shjoo0407/SentiFrame/HW/SentiFrame.csv

Reference | Qty | Value | DNP | Exclude from BOM | Exclude from Board | Exclude from Simulation | Exclude from Position Files | Footprint | Datasheet
BT1 | 1 | 1S protected LiPo >=100mAh |  |  | 기판에서 제외됨 |  | ${EXCLUDE_FROM_POS_FILES}
C1,C10,C12,C15,C17,C23,C25,C26 | 8 | 4.7uF 25V X5R |  |  |  |  | ${EXCLUDE_FROM_POS_FILES} | SentiFrame:C_0603_1608Metric | https://product.tdk.com/en/search/capacitor/ceramic/mlcc/info?part_no=C1608X5R1E475K080AC
C2,C5,C6,C11,C13,C14,C20,C22,C31,C34,C35 | 11 | 100nF 16V X7R |  |  |  |  | ${EXCLUDE_FROM_POS_FILES} | SentiFrame:C_0402_1005Metric | https://product.tdk.com/en/search/capacitor/ceramic/mlcc/info?part_no=C1005X7R1C104K050BC
C7,C8 | 2 | 1uF 25V X5R |  |  | 기판에서 제외됨 |  | ${EXCLUDE_FROM_POS_FILES} | SentiFrame:C_0402_1005Metric | https://product.tdk.com/en/search/capacitor/ceramic/mlcc/info?part_no=C1005X5R1E105K050BC
C9 | 1 | 10uF 25V X5R |  |  | 기판에서 제외됨 |  | ${EXCLUDE_FROM_POS_FILES} | SentiFrame:C_0805_2012Metric | https://product.tdk.com/en/search/capacitor/ceramic/mlcc/info?part_no=C2012X5R1E106K125AB
C16,C19,C27,C28,C29,C30 | 6 | 22uF 25V X5R |  |  |  |  | ${EXCLUDE_FROM_POS_FILES} | SentiFrame:C_0805_2012Metric | https://product.tdk.com/en/search/capacitor/ceramic/mlcc/info?part_no=C2012X5R1E226M125AC
C18,C21 | 2 | 10uF 25V X5R |  |  |  |  | ${EXCLUDE_FROM_POS_FILES} | SentiFrame:C_0805_2012Metric | https://product.tdk.com/en/search/capacitor/ceramic/mlcc/info?part_no=C2012X5R1E106K125AB
C24 | 1 | 4.7nF 50V X7R |  |  |  |  | ${EXCLUDE_FROM_POS_FILES} | SentiFrame:C_0402_1005Metric | https://product.tdk.com/en/search/capacitor/ceramic/mlcc/info?part_no=C1005X7R1H472K050BA
C32 | 1 | 10nF 50V X7R |  |  |  |  | ${EXCLUDE_FROM_POS_FILES} | SentiFrame:C_0402_1005Metric | https://product.tdk.com/en/search/capacitor/ceramic/mlcc/info?part_no=C1005X7R1H103K050BB
C33 | 1 | 1uF 25V X5R |  |  |  |  | ${EXCLUDE_FROM_POS_FILES} | SentiFrame:C_0603_1608Metric | https://product.tdk.com/en/search/capacitor/ceramic/mlcc/info?part_no=C1608X5R1E105K080AC
D1,D2,D3 | 3 | TPD1E10B06DPYR |  |  |  |  | ${EXCLUDE_FROM_POS_FILES} | SentiFrame:D_SOD-523 | https://www.ti.com/lit/ds/symlink/tpd1e10b06.pdf
D4 | 1 | BAT54H,115 |  |  |  |  | ${EXCLUDE_FROM_POS_FILES} | SentiFrame:D_SOD-123F | https://assets.nexperia.com/documents/data-sheet/BAT54H.pdf
D5 | 1 | APHHS1005SURCK |  |  |  |  | ${EXCLUDE_FROM_POS_FILES} | SentiFrame:LED_0402_1005Metric | https://www.kingbrightusa.com/images/catalog/spec/aphhs1005surck.pdf
J1 | 1 | USB4105-GF-A |  |  |  |  | ${EXCLUDE_FROM_POS_FILES} | SentiFrame:USB_C_Receptacle_GCT_USB4105-xx-A_16P_TopMnt_Horizontal | https://gct.co/files/drawings/usb4105.pdf
J2 | 1 | JST SH / PACK + GND NTC |  |  |  |  | ${EXCLUDE_FROM_POS_FILES} | SentiFrame:JST_SH_SM03B-SRSS-TB_1x03-1MP_P1.00mm_Horizontal
J4 | 1 | SM05B-SURS-TF / PPG MAIN |  |  |  |  | ${EXCLUDE_FROM_POS_FILES} | SentiFrame:JST_SUR_SM05B-SURS-TF_J4_SilkClearance | https://www.jst-mfg.com/product/pdf/eng/eSUR.pdf
J5 | 1 | SM05B-SURS-TF / PPG REMOTE |  |  | 기판에서 제외됨 |  | ${EXCLUDE_FROM_POS_FILES} | SentiFrame:JST_SUR_SM05B-SURS-TF_1x05-1MP_P0.80mm_Horizontal | https://www.jst-mfg.com/product/pdf/eng/eSUR.pdf
L1 | 1 | 4.7uH / 0.30A Isat typ |  |  |  |  | ${EXCLUDE_FROM_POS_FILES} | SentiFrame:L_HPC160809TF_DS | https://www.tai-tech.com.tw/pdf/284799/HPC160809TF-SERIES.pdf
L2,L3 | 2 | 2.2uH DFE201612E |  |  |  |  | ${EXCLUDE_FROM_POS_FILES} | SentiFrame:L_DFE201612E_DS | https://www.ti.com/lit/ds/symlink/tps62840.pdf,https://www.ti.com/lit/ds/symlink/tps63900.pdf
M1 | 1 | PMD 303-103 / external |  |  | 기판에서 제외됨 |  | ${EXCLUDE_FROM_POS_FILES} |  | https://precisionmicrodrives.com/cdn/catalog_product/a43fe981-4a1e-4aa2-bfc0-005ce2c3eb36/303-103-datasheet.pdf
Q1,Q2,Q3,Q4,Q5 | 5 | DMN1019USN-7 |  |  |  |  | ${EXCLUDE_FROM_POS_FILES} | SentiFrame:SC-59 | https://www.diodes.com/assets/Datasheets/DMN1019USN.pdf
R1,R8,R13,R16,R17,R36,R37,R38 | 8 | 10k 1% |  |  |  |  | ${EXCLUDE_FROM_POS_FILES} | SentiFrame:R_0402_1005Metric | https://yageogroup.com/content/datasheet/asset/file/PYU-RC_GROUP_51_ROHS_L
R2,R3,R20 | 3 | 2.2k 1% |  |  |  |  | ${EXCLUDE_FROM_POS_FILES} | SentiFrame:R_0402_1005Metric | https://yageogroup.com/content/datasheet/asset/file/PYU-RC_GROUP_51_ROHS_L
R4,R5,R12,R14,R15,R19,R21,R25,R26,R27,R28,R30,R31,R39 | 14 | 100k 1% |  |  |  |  | ${EXCLUDE_FROM_POS_FILES} | SentiFrame:R_0402_1005Metric | https://yageogroup.com/content/datasheet/asset/file/PYU-RC_GROUP_51_ROHS_L
R9 | 1 | 22.1k 1% |  |  |  |  | ${EXCLUDE_FROM_POS_FILES} | SentiFrame:R_0402_1005Metric | https://yageogroup.com/content/datasheet/asset/file/PYU-RC_GROUP_51_ROHS_L
R10 | 1 | 47.5k 1% |  |  |  |  | ${EXCLUDE_FROM_POS_FILES} | SentiFrame:R_0402_1005Metric | https://yageogroup.com/content/datasheet/asset/file/PYU-RC_GROUP_51_ROHS_L
R11 | 1 | 1k 1% |  |  |  |  | ${EXCLUDE_FROM_POS_FILES} | SentiFrame:R_0402_1005Metric | https://yageogroup.com/content/datasheet/asset/file/PYU-RC_GROUP_51_ROHS_L
R18 | 1 | 100 1% |  |  |  |  | ${EXCLUDE_FROM_POS_FILES} | SentiFrame:R_0402_1005Metric | https://yageogroup.com/content/datasheet/asset/file/PYU-RC_GROUP_51_ROHS_L
R22,R24 | 2 | 36.5k 1% |  |  |  |  | ${EXCLUDE_FROM_POS_FILES} | SentiFrame:R_0402_1005Metric | https://yageogroup.com/content/datasheet/asset/file/PYU-RC_GROUP_51_ROHS_L
R23 | 1 | 8.25k 1% |  |  |  |  | ${EXCLUDE_FROM_POS_FILES} | SentiFrame:R_0402_1005Metric | https://yageogroup.com/content/datasheet/asset/file/PYU-RC_GROUP_51_ROHS_L
R29 | 1 | 47k 1% |  |  |  |  | ${EXCLUDE_FROM_POS_FILES} | SentiFrame:R_0402_1005Metric | https://yageogroup.com/content/datasheet/asset/file/PYU-RC_GROUP_51_ROHS_L
R32 | 1 | 1.74k 1% |  |  |  |  | ${EXCLUDE_FROM_POS_FILES} | SentiFrame:R_0402_1005Metric | https://yageogroup.com/content/datasheet/asset/file/PYU-RC_GROUP_51_ROHS_L
R33,R34,R35 | 3 | 2.2 1% |  |  |  |  | ${EXCLUDE_FROM_POS_FILES} | SentiFrame:R_0402_1005Metric | https://yageogroup.com/content/datasheet/asset/file/PYU-RC_GROUP_51_ROHS_L
R40 | 1 | 887k 1% |  |  |  |  | ${EXCLUDE_FROM_POS_FILES} | SentiFrame:R_0402_1005Metric | https://yageogroup.com/content/datasheet/asset/file/PYU-RC_GROUP_51_ROHS_L
SW1 | 1 | B3U-1000P / SOS |  |  |  |  | ${EXCLUDE_FROM_POS_FILES} | SentiFrame:SW_SPST_B3U-1000P | https://components.omron.com/us-en/system/files/2023-01/datasheet_pdf/A162-E1.pdf
SW2 | 1 | B3U-1000P / POWER |  |  |  |  | ${EXCLUDE_FROM_POS_FILES} | SentiFrame:SW_SPST_B3U-1000P | https://components.omron.com/us-en/system/files/2023-01/datasheet_pdf/A162-E1.pdf
TH1 | 1 | SEMITEC 103AT-2 / external |  |  | 기판에서 제외됨 |  | ${EXCLUDE_FROM_POS_FILES} |  | https://www.semitec-global.com/uploads/2022/01/P12-13-AT-Thermistor.pdf
U1 | 1 | AN54LV-15 |  |  |  |  | ${EXCLUDE_FROM_POS_FILES} | SentiFrame:AN54LV-15 | https://www.raytac.com/document/act.php?act=1&index_id=101
U2 | 1 | BMI270 / I2C 0x68 |  |  |  |  | ${EXCLUDE_FROM_POS_FILES} | SentiFrame:BMI270_LGA14_DS00008 | https://www.bosch-sensortec.com/media/boschsensortec/downloads/datasheets/bst-bmi270-ds000.pdf
U3 | 1 | MAXM86161AEFD+T / 0x62 |  |  | 기판에서 제외됨 |  | ${EXCLUDE_FROM_POS_FILES} | SentiFrame:MAXM86161A_OLGA14_2.9x4.3mm | https://www.analog.com/media/en/technical-documentation/data-sheets/maxm86161a.pdf
U4 | 1 | CP2102N-A02-GQFN20 |  |  |  |  | ${EXCLUDE_FROM_POS_FILES} | SentiFrame:SiliconLabs_QFN-20-1EP_3x3mm_P0.5mm_EP1.8x1.8mm | https://www.silabs.com/documents/public/data-sheets/cp2102n-datasheet.pdf
U5 | 1 | TXU0202DCUR |  |  |  |  | ${EXCLUDE_FROM_POS_FILES} | SentiFrame:VSSOP-8_2.3x2mm_P0.5mm | https://www.ti.com/lit/ds/symlink/txu0202.pdf
U6 | 1 | TPD2EUSB30DRTR |  |  |  |  | ${EXCLUDE_FROM_POS_FILES} | SentiFrame:Texas_DRT-3 | https://www.ti.com/lit/ds/symlink/tpd2eusb30.pdf
U7 | 1 | BQ25186DLHR / 0x6A |  |  |  |  | ${EXCLUDE_FROM_POS_FILES} | SentiFrame:Texas_DLH0010A_WSON-10-1EP_2.2x2mm_P0.4mm_EP0.9x1.5mm | https://www.ti.com/lit/ds/symlink/bq25186.pdf
U8 | 1 | TPS62840DLCR / 2.0V |  |  |  |  | ${EXCLUDE_FROM_POS_FILES} | SentiFrame:Texas_VSON-HR-8_1.5x2mm_P0.5mm | https://www.ti.com/lit/ds/symlink/tps62840.pdf
U9 | 1 | TPS63900DSKR / PPG 5V |  |  |  |  | ${EXCLUDE_FROM_POS_FILES} | SentiFrame:WSON-10-1EP_2.5x2.5mm_P0.5mm_EP1.2x2mm | https://www.ti.com/lit/ds/symlink/tps63900.pdf
U10 | 1 | TPS7A0230PDBVR / 3V |  |  |  |  | ${EXCLUDE_FROM_POS_FILES} | SentiFrame:SOT-23-5 | https://www.ti.com/lit/ds/symlink/tps7a02.pdf
U11 | 1 | TPS22918DBVR |  |  |  |  | ${EXCLUDE_FROM_POS_FILES} | SentiFrame:SOT-23-6 | https://www.ti.com/lit/ds/symlink/tps22918.pdf
U12 | 1 | TPS22918DBVR / ADC gate |  |  |  |  | ${EXCLUDE_FROM_POS_FILES} | SentiFrame:SOT-23-6 | https://www.ti.com/lit/ds/symlink/tps22918.pdf
U13 | 1 | BQ24392RSER |  |  |  |  | ${EXCLUDE_FROM_POS_FILES} | SentiFrame:Texas_UQFN-10_1.5x2mm_P0.5mm | https://www.ti.com/lit/ds/symlink/bq24392.pdf
U14 | 1 | TUSB320LAIRWBR / 0x47 |  |  |  |  | ${EXCLUDE_FROM_POS_FILES} | SentiFrame:Texas_X2QFN-12_1.6x1.6mm_P0.4mm | https://www.ti.com/lit/ds/symlink/tusb320lai.pdf
