shjoo0407/SentiFrame/HW/SentiFrame-PPG.kicad_pcb

## KiCad design HW/SentiFrame-PPG.kicad_pcb (2026-11-08)

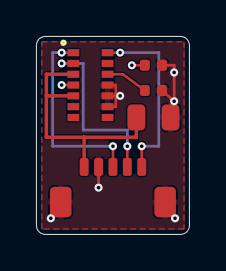
[picture p1: board SentiFrame-PPG.kicad_pcb from above]

Board: 4 copper layers, 8.5 x 11.0 mm, 5 parts (0 on the bottom side), 7 nets.

Parts:
C7, C8: 1uF 25V X5R; C_0402_1005Metric
C9: 10uF 25V X5R; C_0805_2012Metric
J5: SM05B-SURS-TF / PPG REMOTE; JST_SUR_SM05B-SURS-TF_1x05-1MP_P0.80mm_Horizontal
U3: MAXM86161AEFD+T / 0x62; MAXM86161A_OLGA14_2.9x4.3mm

Connections:
GND: C7.2, C8.2, C9.2, J5.2, J5.MP, U3.9, U3.10, U3.11
I2C_SCL: J5.4, U3.2
I2C_SDA: J5.3, U3.1
PPG5V: C9.1, J5.1, U3.3, U3.5
PPG_INT_N: J5.5, U3.14
PPG_VLDO: C7.1, U3.4
PPG_VREF: C8.1, U3.12
