shjoo0407/SentiFrame/HW/SentiFrame.kicad_pcb

## KiCad design HW/SentiFrame.kicad_pcb (2026-11-08)

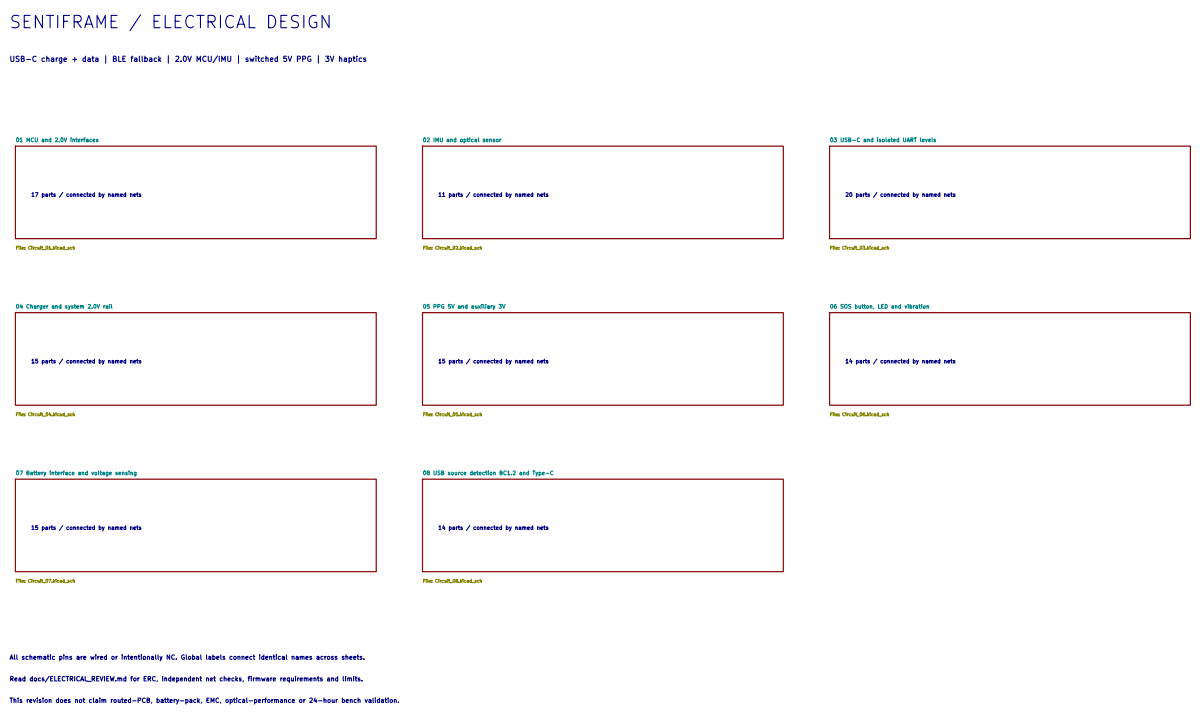
[picture p2: schematic SentiFrame.kicad_sch, SentiFrame / Electrical schematic revision F]

Notes on the sheet:
SENTIFRAME / ELECTRICAL DESIGN
USB-C charge + data | BLE fallback | 2.0V MCU/IMU | switched 5V PPG | 3V haptics
17 parts / connected by named nets
11 parts / connected by named nets
20 parts / connected by named nets
15 parts / connected by named nets
14 parts / connected by named nets
All schematic pins are wired or intentionally NC. Global labels connect identical names across sheets.
Read docs/ELECTRICAL_REVIEW.md for ERC, independent net checks, firmware requirements and limits.
This revision does not claim routed-PCB, battery-pack, EMC, optical-performance or 24-hour bench validation.

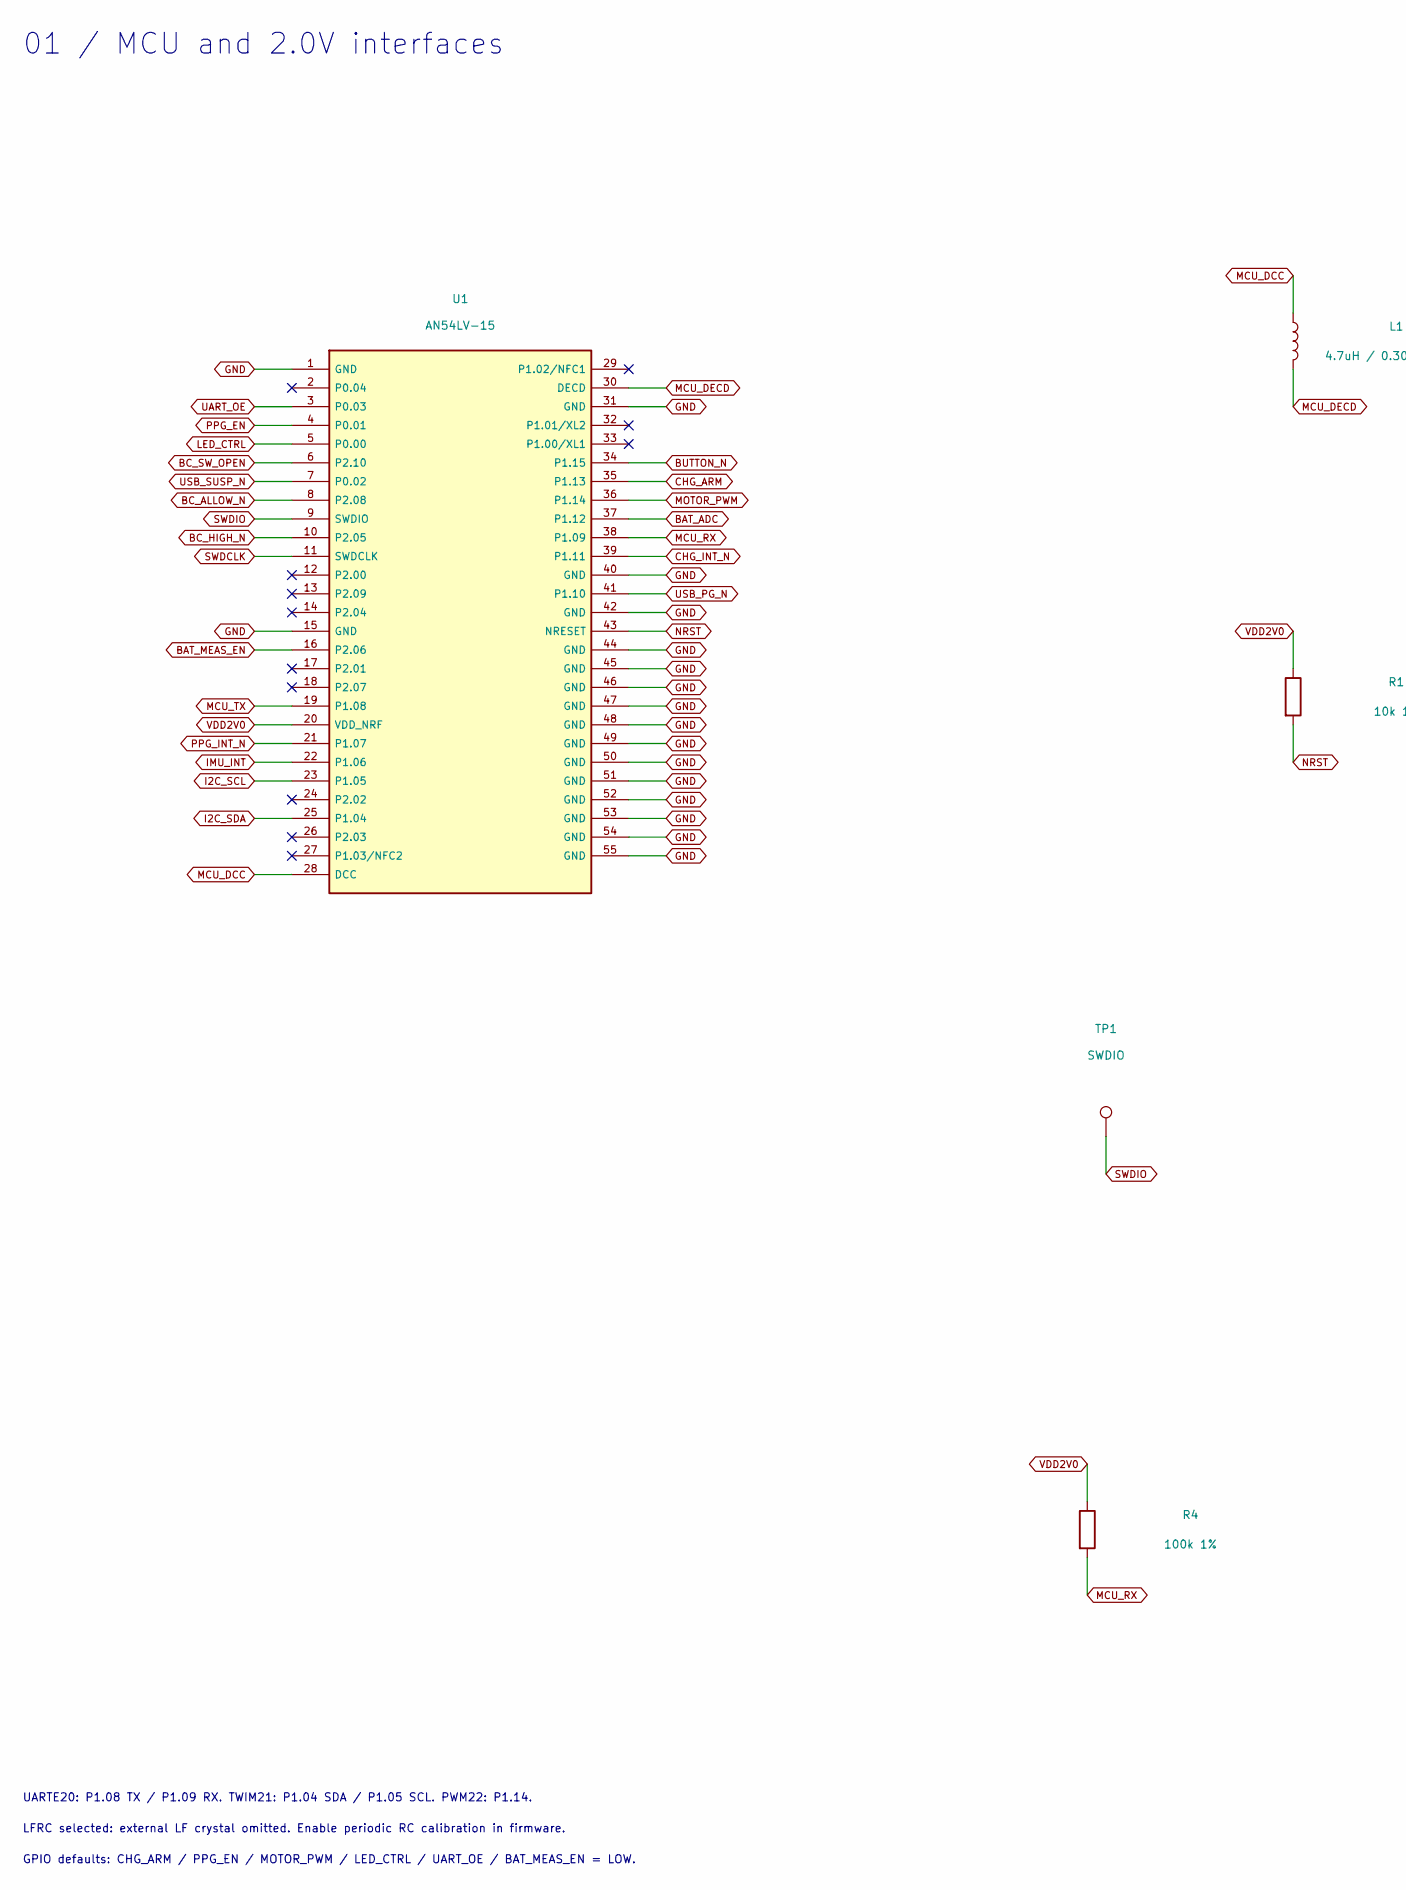
[picture p3: schematic Circuit_01.kicad_sch, MCU and 2.0V interfaces, part in row 1, column 1]

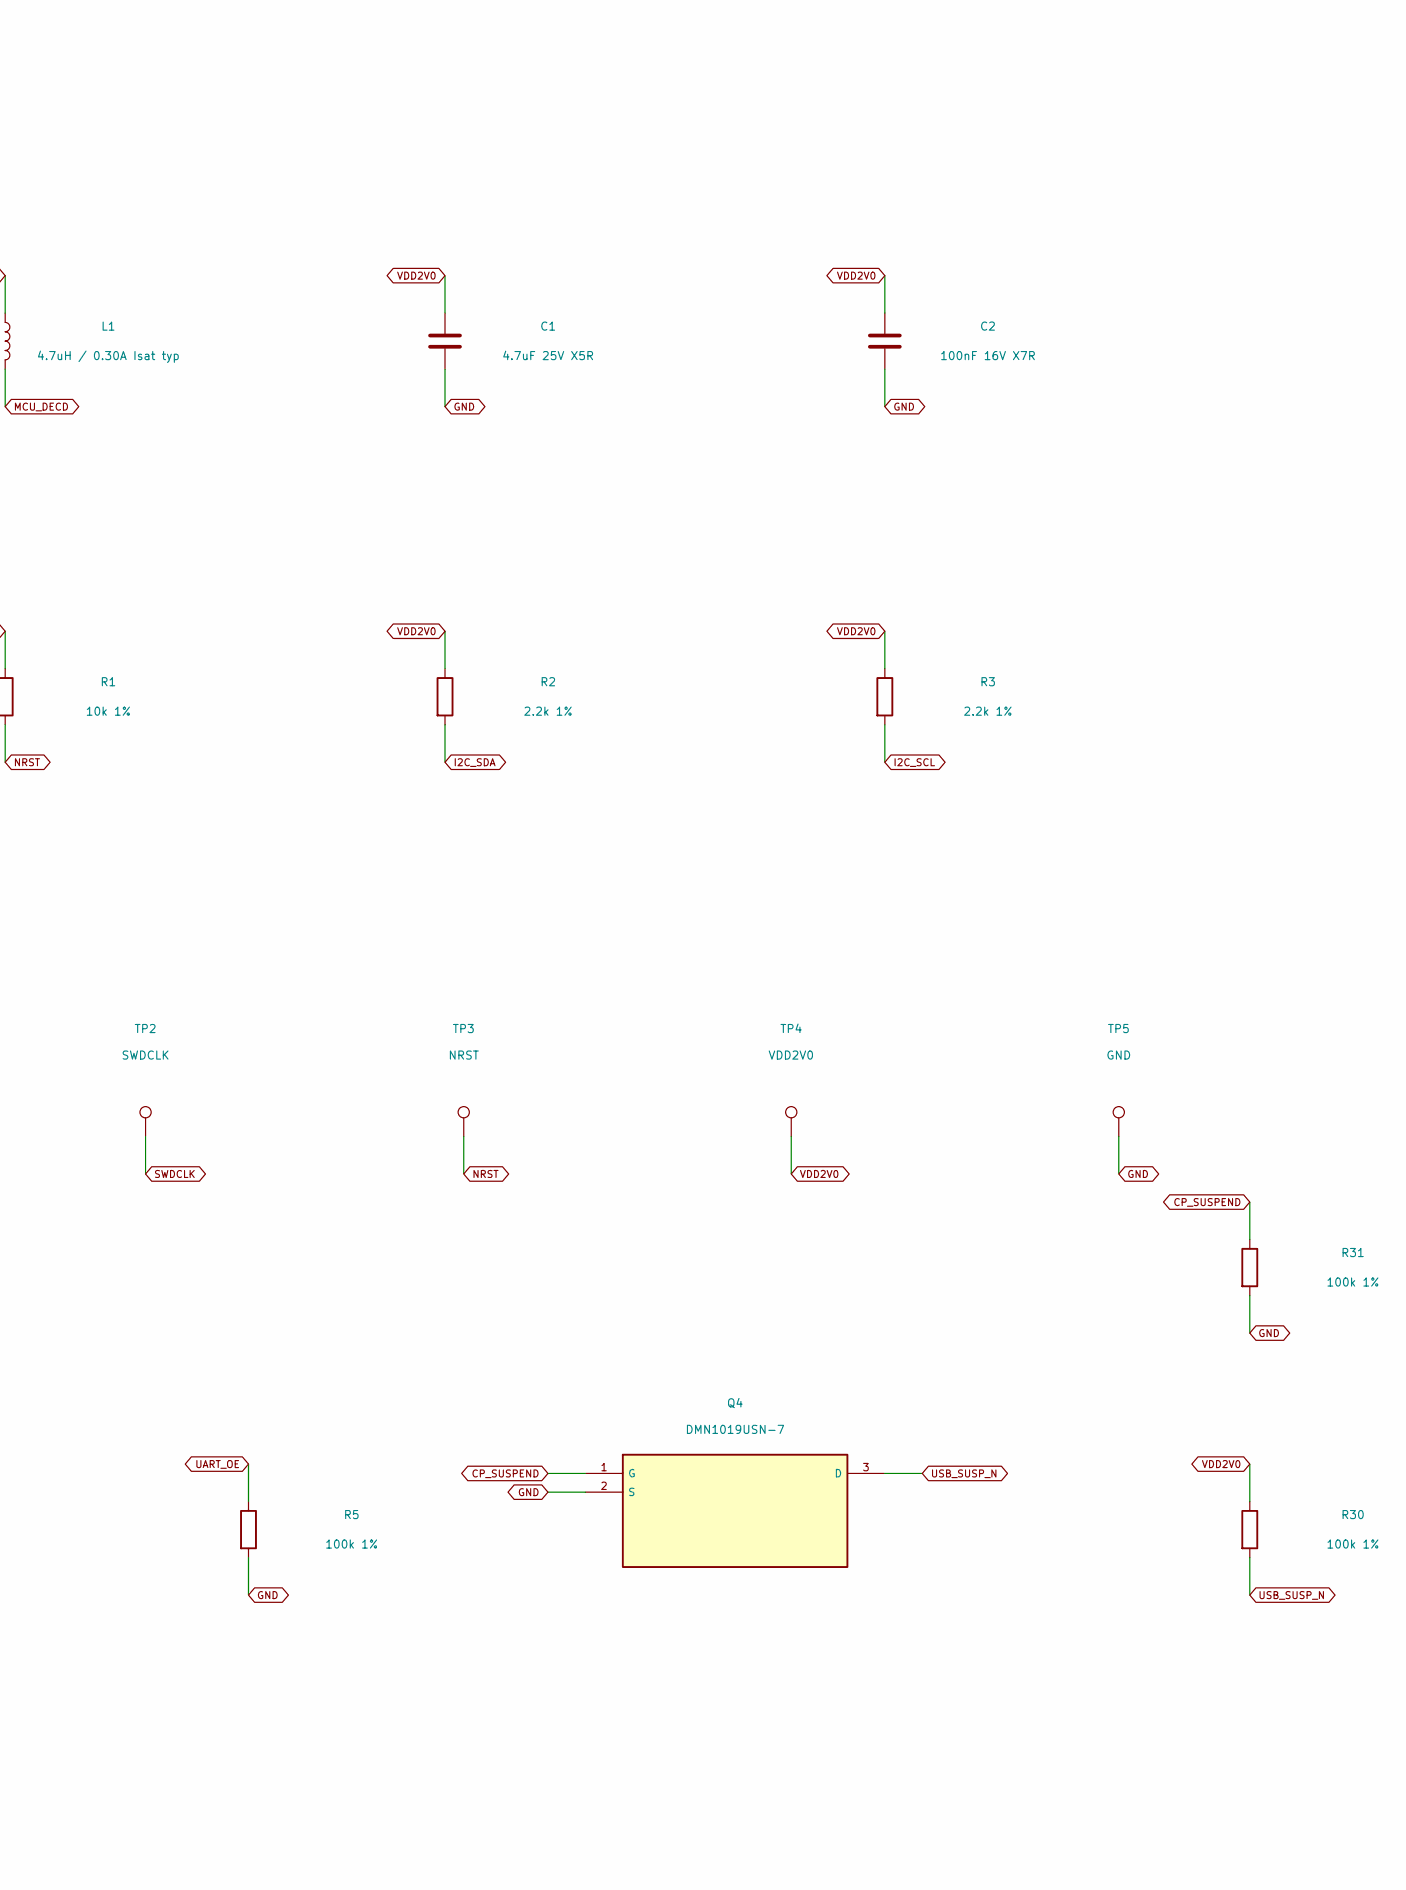
[picture p4: schematic Circuit_01.kicad_sch, MCU and 2.0V interfaces, part in row 1, column 2]

Parts:
C1: 4.7uF 25V X5R; C_0603_1608Metric; MPN C1608X5R1E475K080AC
C2: 100nF 16V X7R; C_0402_1005Metric; MPN C1005X7R1C104K050BC
L1: 4.7uH / 0.30A Isat typ; L_HPC160809TF_DS; MPN HPC160809TF-4R7M
Q4: DMN1019USN-7; SC-59; MPN DMN1019USN-7
R1: 10k 1%; R_0402_1005Metric; MPN RC0402FR-0710KL
R2, R3: 2.2k 1%; R_0402_1005Metric; MPN RC0402FR-072K2L
R4, R5, R30, R31: 100k 1%; R_0402_1005Metric; MPN RC0402FR-07100KL
TP1: SWDIO; TestPoint_Pad_D1.0mm
TP2: SWDCLK; TestPoint_Pad_D1.0mm
TP3: NRST; TestPoint_Pad_D1.0mm
TP4: VDD2V0; TestPoint_Pad_D1.0mm
TP5: GND; TestPoint_Pad_D1.0mm
U1: AN54LV-15; MPN AN54LV-15

Connections:
BAT_ADC: U1.37 (P1.12); also elsewhere on the board
BAT_MEAS_EN: U1.16 (P2.06); also elsewhere on the board
BC_ALLOW_N: U1.8 (P2.08); also elsewhere on the board
BC_HIGH_N: U1.10 (P2.05); also elsewhere on the board
BC_SW_OPEN: U1.6 (P2.10); also elsewhere on the board
BUTTON_N: U1.34 (P1.15); also elsewhere on the board
CHG_ARM: U1.35 (P1.13); also elsewhere on the board
CHG_INT_N: U1.39 (P1.11); also elsewhere on the board
CP_SUSPEND: Q4.1 (G), R31.1; also elsewhere on the board
GND: C1.2, C2.2, Q4.2 (S), R5.2, R31.2, TP5.1, U1.1 (GND), U1.15 (GND), U1.31 (GND), U1.40 (GND), U1.42 (GND), U1.44 (GND), U1.45 (GND), U1.46 (GND), U1.47 (GND), U1.48 (GND), U1.49 (GND), U1.50 (GND), U1.51 (GND), U1.52 (GND), U1.53 (GND), U1.54 (GND), U1.55 (GND); also elsewhere on the board
I2C_SCL: R3.2, U1.23 (P1.05); also elsewhere on the board
I2C_SDA: R2.2, U1.25 (P1.04); also elsewhere on the board
IMU_INT: U1.22 (P1.06); also elsewhere on the board
LED_CTRL: U1.5 (P0.00); also elsewhere on the board
MCU_DCC: L1.1, U1.28 (DCC)
MCU_DECD: L1.2, U1.30 (DECD)
MCU_RX: R4.2, U1.38 (P1.09); also elsewhere on the board
MCU_TX: U1.19 (P1.08); also elsewhere on the board
MOTOR_PWM: U1.36 (P1.14); also elsewhere on the board
NRST: R1.2, TP3.1, U1.43 (NRESET)
PPG_EN: U1.4 (P0.01); also elsewhere on the board
PPG_INT_N: U1.21 (P1.07); also elsewhere on the board
SWDCLK: TP2.1, U1.11 (SWDCLK)
SWDIO: TP1.1, U1.9 (SWDIO)
UART_OE: R5.1, U1.3 (P0.03); also elsewhere on the board
USB_PG_N: U1.41 (P1.10); also elsewhere on the board
USB_SUSP_N: Q4.3 (D), R30.2, U1.7 (P0.02)
VDD2V0: C1.1, C2.1, R1.1, R2.1, R3.1, R4.1, R30.1, TP4.1, U1.20 (VDD_NRF); also elsewhere on the board

Notes on the sheet:
01 / MCU and 2.0V interfaces
UARTE20: P1.08 TX / P1.09 RX. TWIM21: P1.04 SDA / P1.05 SCL. PWM22: P1.14.
LFRC selected: external LF crystal omitted. Enable periodic RC calibration in firmware.
GPIO defaults: CHG_ARM / PPG_EN / MOTOR_PWM / LED_CTRL / UART_OE / BAT_MEAS_EN = LOW.

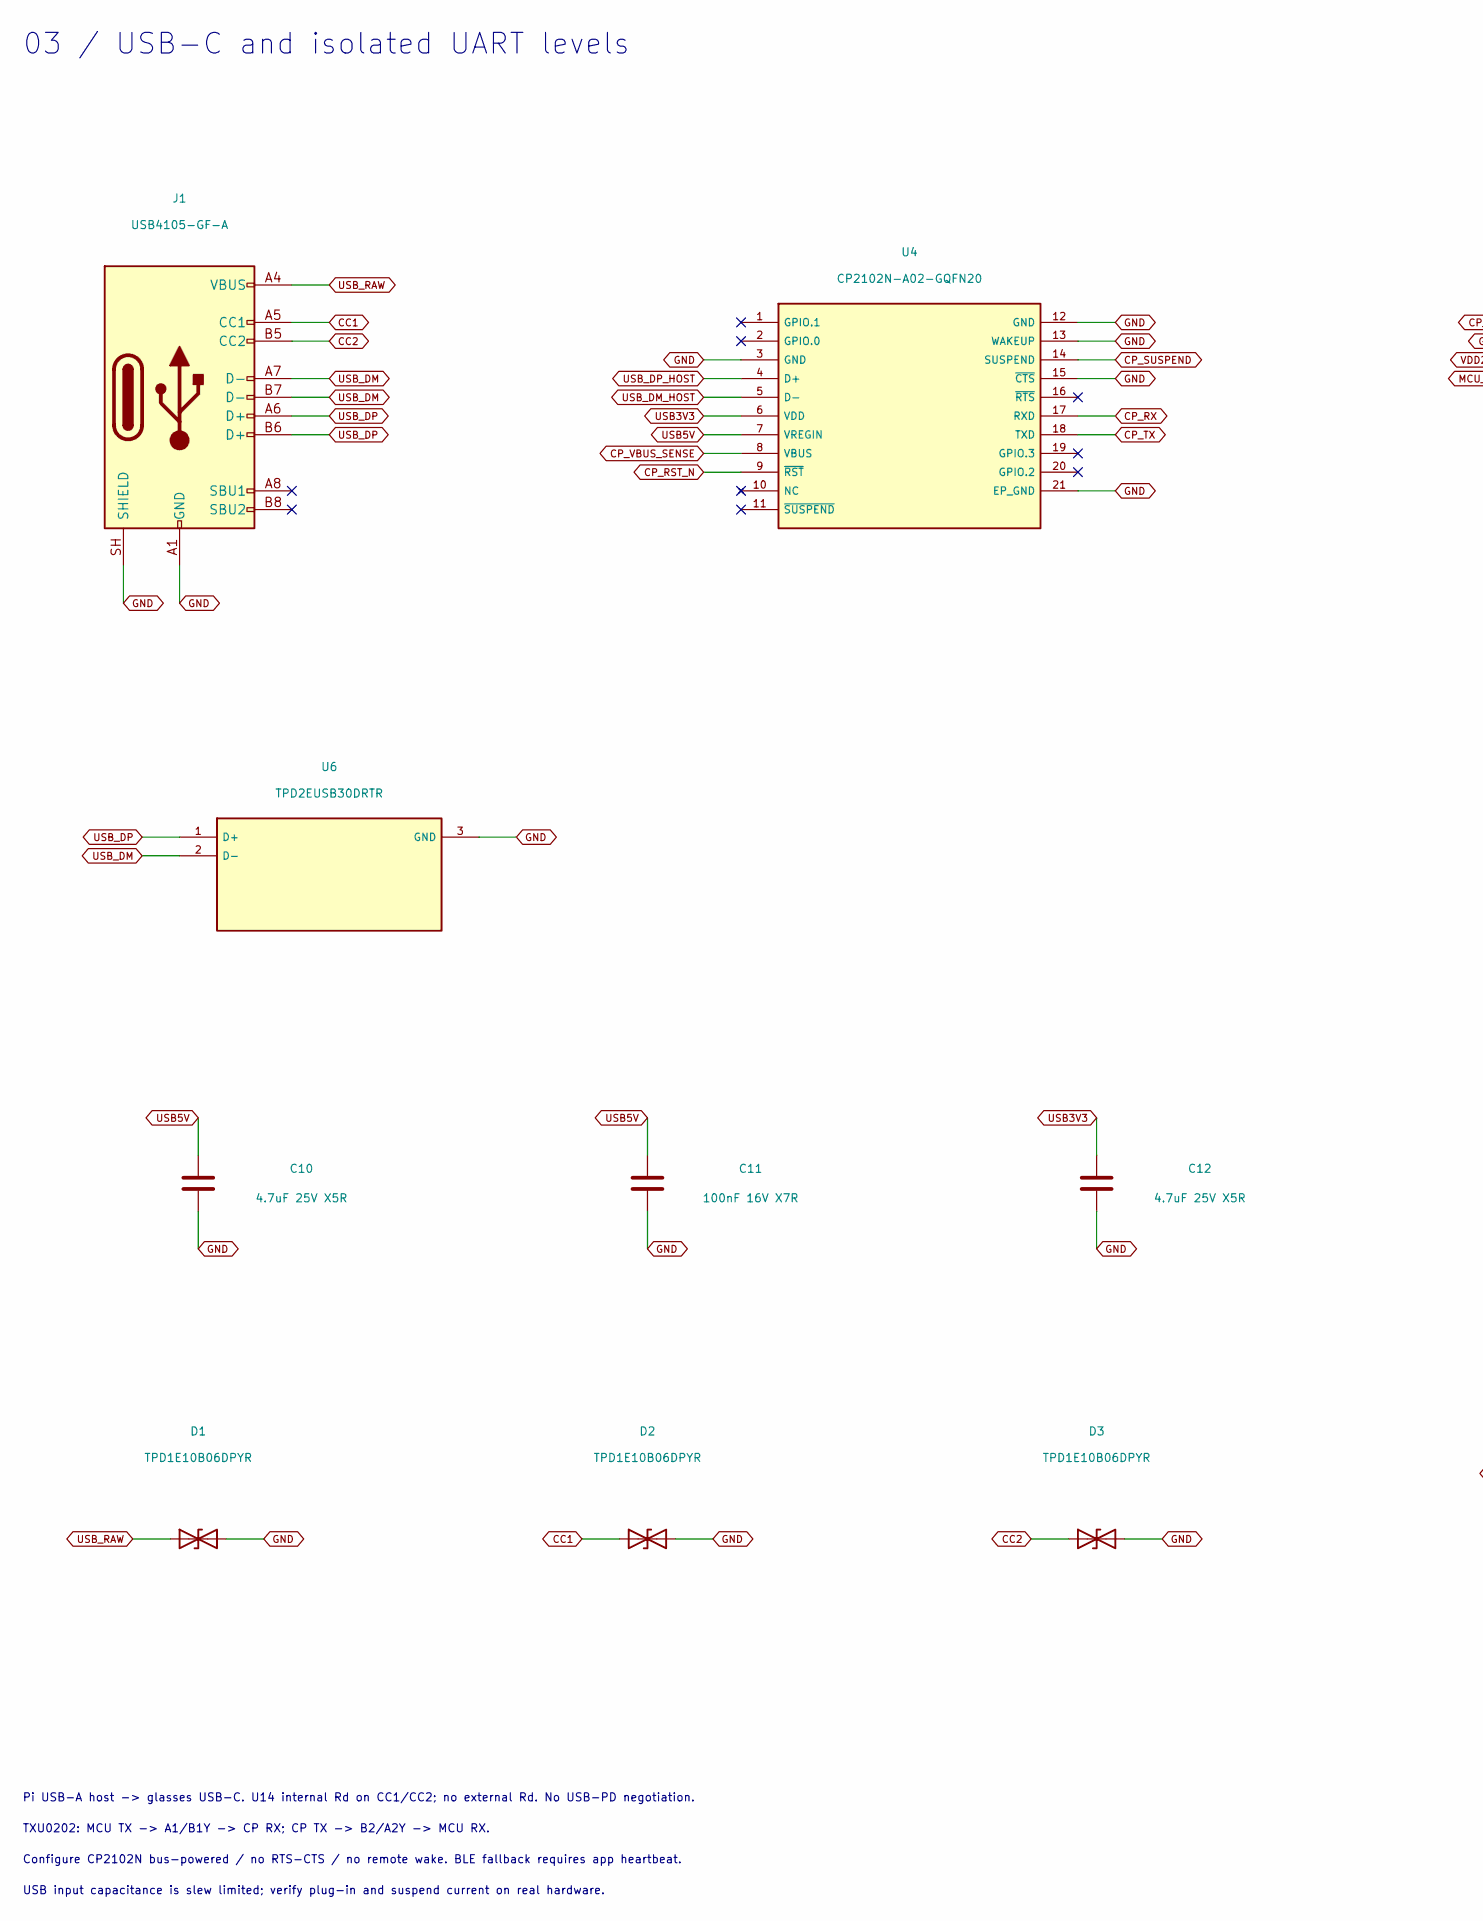
[picture p5: schematic Circuit_03.kicad_sch, USB-C and isolated UART levels, part in row 1, column 1]

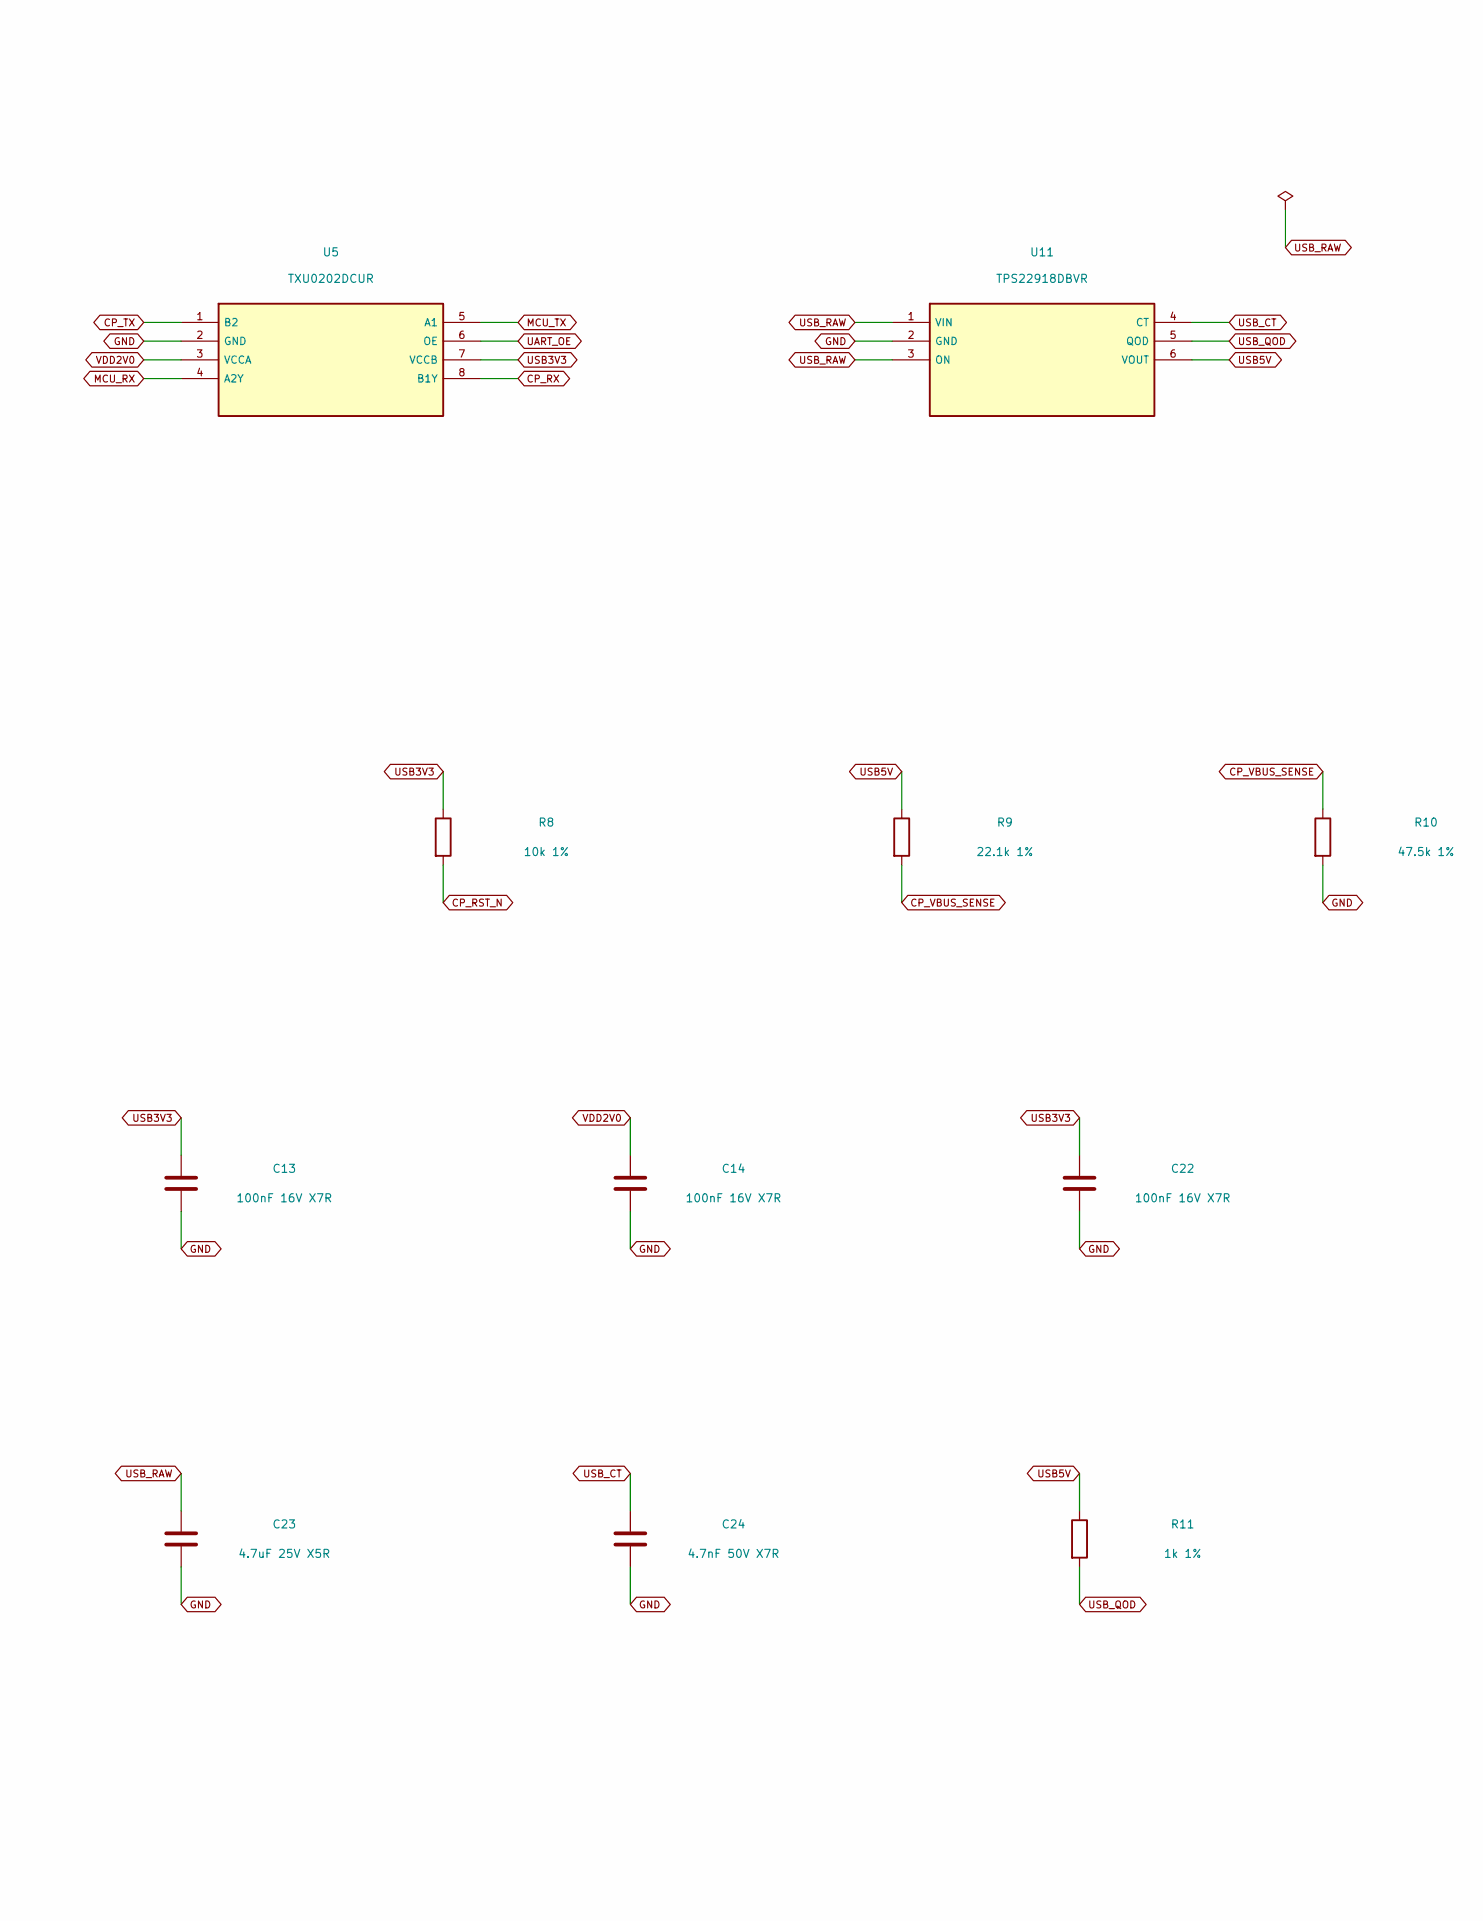
[picture p6: schematic Circuit_03.kicad_sch, USB-C and isolated UART levels, part in row 1, column 2]

Parts:
C10, C12, C23: 4.7uF 25V X5R; C_0603_1608Metric; MPN C1608X5R1E475K080AC
C11, C13, C14, C22: 100nF 16V X7R; C_0402_1005Metric; MPN C1005X7R1C104K050BC
C24: 4.7nF 50V X7R; C_0402_1005Metric; MPN C1005X7R1H472K050BA
D1, D2, D3: TPD1E10B06DPYR; D_SOD-523; MPN TPD1E10B06DPYR
J1: USB4105-GF-A; USB_C_Receptacle_GCT_USB4105-xx-A_16P_TopMnt_Horizontal; MPN USB4105-GF-A
R8: 10k 1%; R_0402_1005Metric; MPN RC0402FR-0710KL
R9: 22.1k 1%; R_0402_1005Metric; MPN RC0402FR-0722K1L
R10: 47.5k 1%; R_0402_1005Metric; MPN RC0402FR-0747K5L
R11: 1k 1%; R_0402_1005Metric; MPN RC0402FR-071KL
U4: CP2102N-A02-GQFN20; SiliconLabs_QFN-20-1EP_3x3mm_P0.5mm_EP1.8x1.8mm; MPN CP2102N-A02-GQFN20
U5: TXU0202DCUR; VSSOP-8_2.3x2mm_P0.5mm; MPN TXU0202DCUR
U6: TPD2EUSB30DRTR; Texas_DRT-3; MPN TPD2EUSB30DRTR
U11: TPS22918DBVR; SOT-23-6; MPN TPS22918DBVR

Connections:
CC1: D2.1 (A1), J1.A5 (CC1); also elsewhere on the board
CC2: D3.1 (A1), J1.B5 (CC2); also elsewhere on the board
CP_RST_N: R8.2, U4.9 (~RST)
CP_RX: U4.17 (RXD), U5.8 (B1Y)
CP_SUSPEND: U4.14 (SUSPEND); also elsewhere on the board
CP_TX: U4.18 (TXD), U5.1 (B2)
CP_VBUS_SENSE: R9.2, R10.1, U4.8 (VBUS)
GND: C10.2, C11.2, C12.2, C13.2, C14.2, C22.2, C23.2, C24.2, D1.2 (A2), D2.2 (A2), D3.2 (A2), J1.A1 (GND), J1.A12 (GND), J1.B1 (GND), J1.B12 (GND), J1.SH (SHIELD), R10.2, U4.3 (GND), U4.12 (GND), U4.13 (WAKEUP), U4.15 (~CTS), U4.21 (EP_GND), U5.2 (GND), U6.3 (GND), U11.2 (GND); also elsewhere on the board
MCU_RX: U5.4 (A2Y); also elsewhere on the board
MCU_TX: U5.5 (A1); also elsewhere on the board
UART_OE: U5.6 (OE); also elsewhere on the board
USB3V3: C12.1, C13.1, C22.1, R8.1, U4.6 (VDD), U5.7 (VCCB); also elsewhere on the board
USB5V: C10.1, C11.1, R9.1, R11.1, U4.7 (VREGIN), U11.6 (VOUT); also elsewhere on the board
USB_CT: C24.1, U11.4 (CT)
USB_DM: J1.A7 (D-), J1.B7 (D-), U6.2 (D-); also elsewhere on the board
USB_DM_HOST: U4.5 (D-); also elsewhere on the board
USB_DP: J1.A6 (D+), J1.B6 (D+), U6.1 (D+); also elsewhere on the board
USB_DP_HOST: U4.4 (D+); also elsewhere on the board
USB_QOD: R11.2, U11.5 (QOD)
USB_RAW: C23.1, D1.1 (A1), J1.A4 (VBUS), J1.A9 (VBUS), J1.B4 (VBUS), J1.B9 (VBUS), U11.1 (VIN), U11.3 (ON); also elsewhere on the board
VDD2V0: C14.1, U5.3 (VCCA); also elsewhere on the board

Notes on the sheet:
03 / USB-C and isolated UART levels
Pi USB-A host -> glasses USB-C. U14 internal Rd on CC1/CC2; no external Rd. No USB-PD negotiation.
TXU0202: MCU TX -> A1/B1Y -> CP RX; CP TX -> B2/A2Y -> MCU RX.
Configure CP2102N bus-powered / no RTS-CTS / no remote wake. BLE fallback requires app heartbeat.
USB input capacitance is slew limited; verify plug-in and suspend current on real hardware.

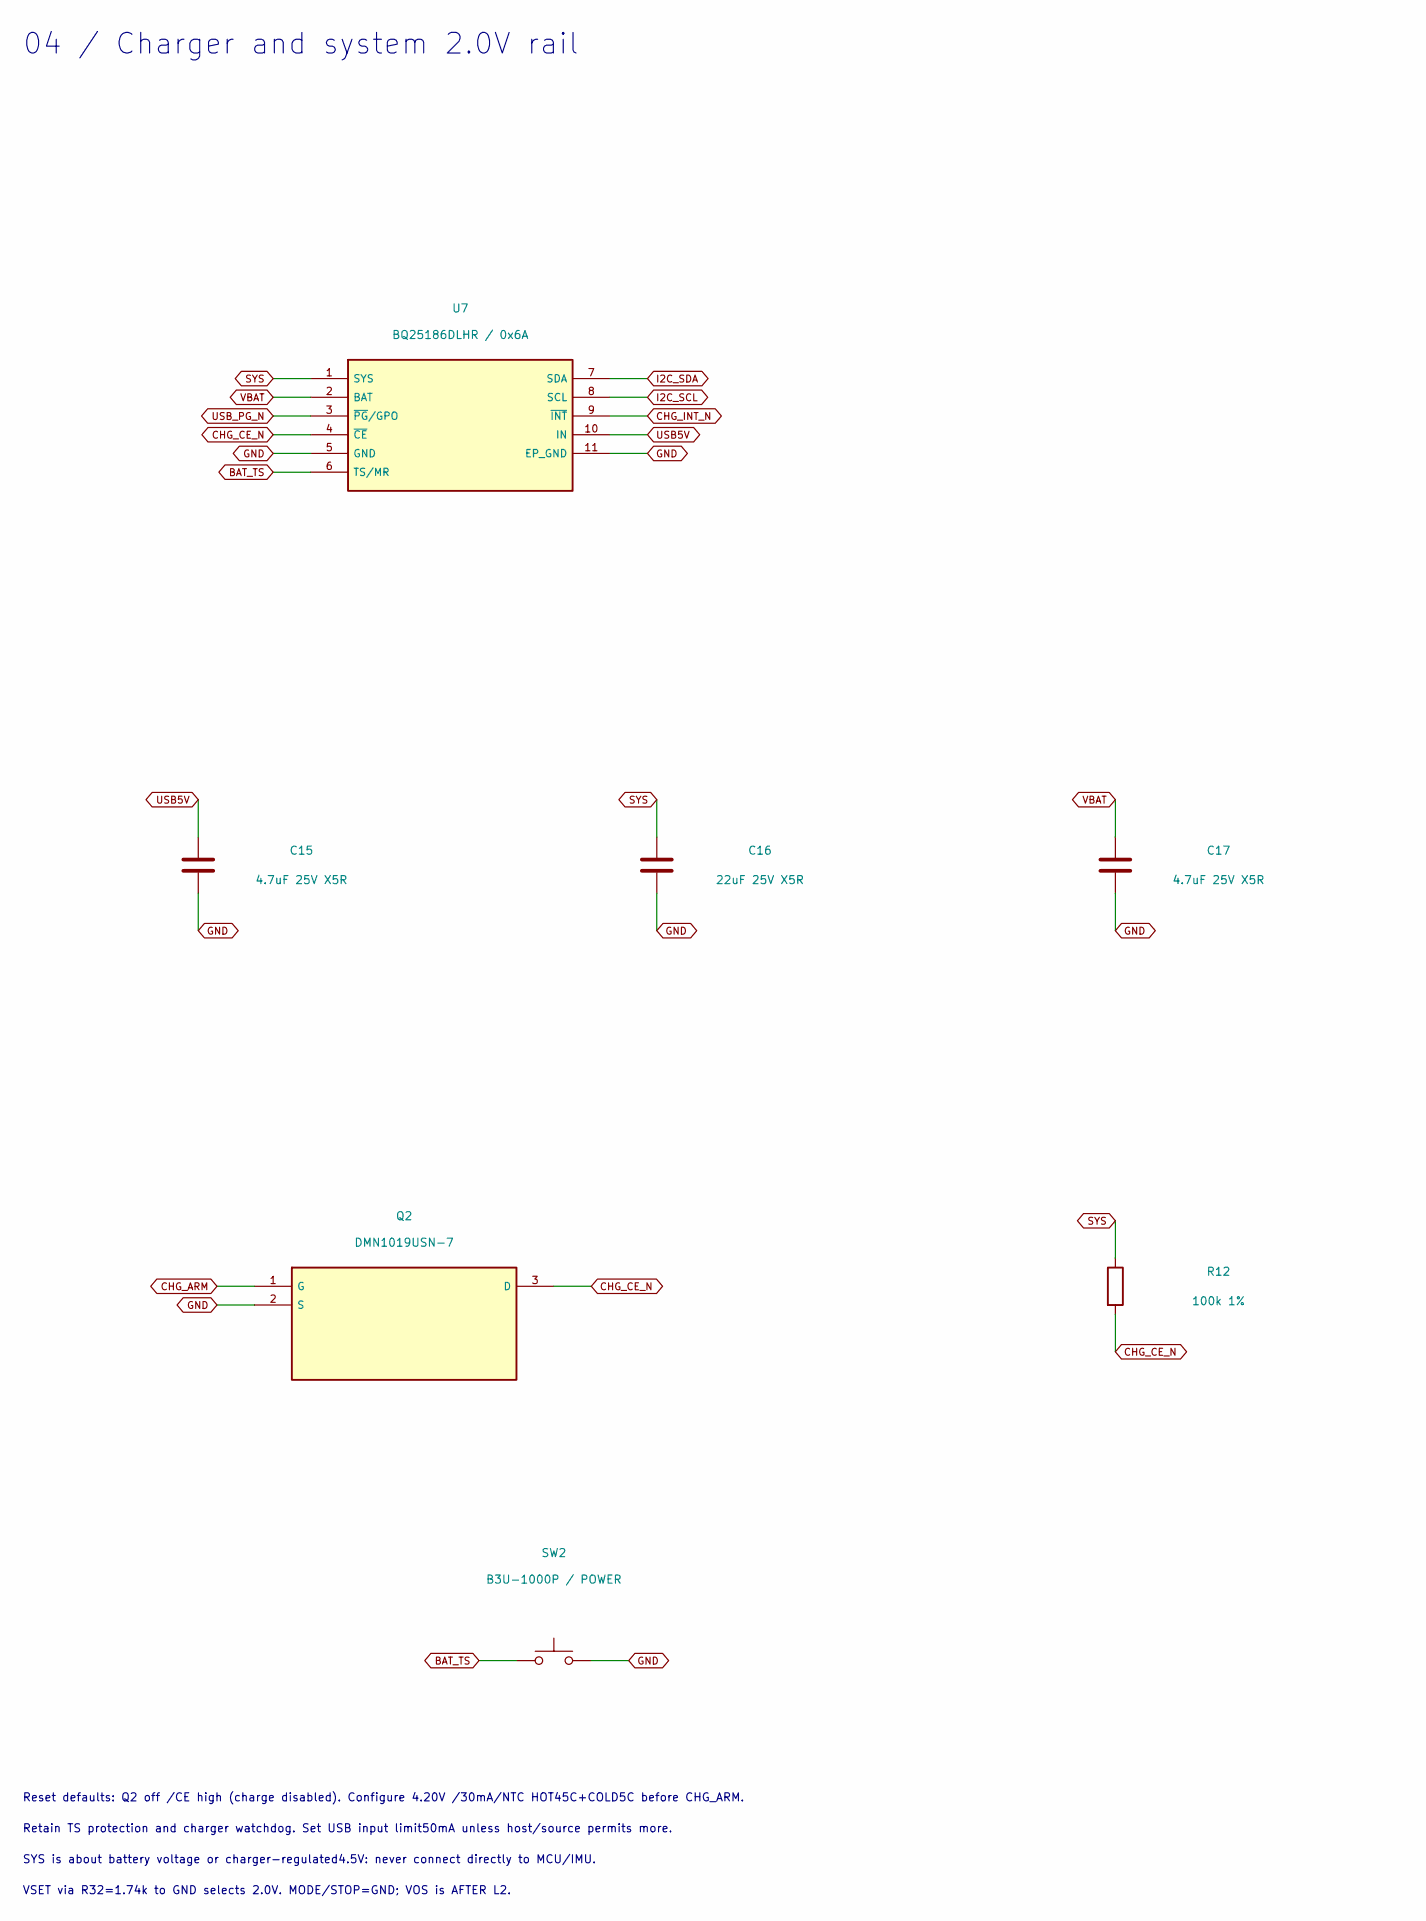
[picture p7: schematic Circuit_04.kicad_sch, Charger and system 2.0V rail, part in row 1, column 1]

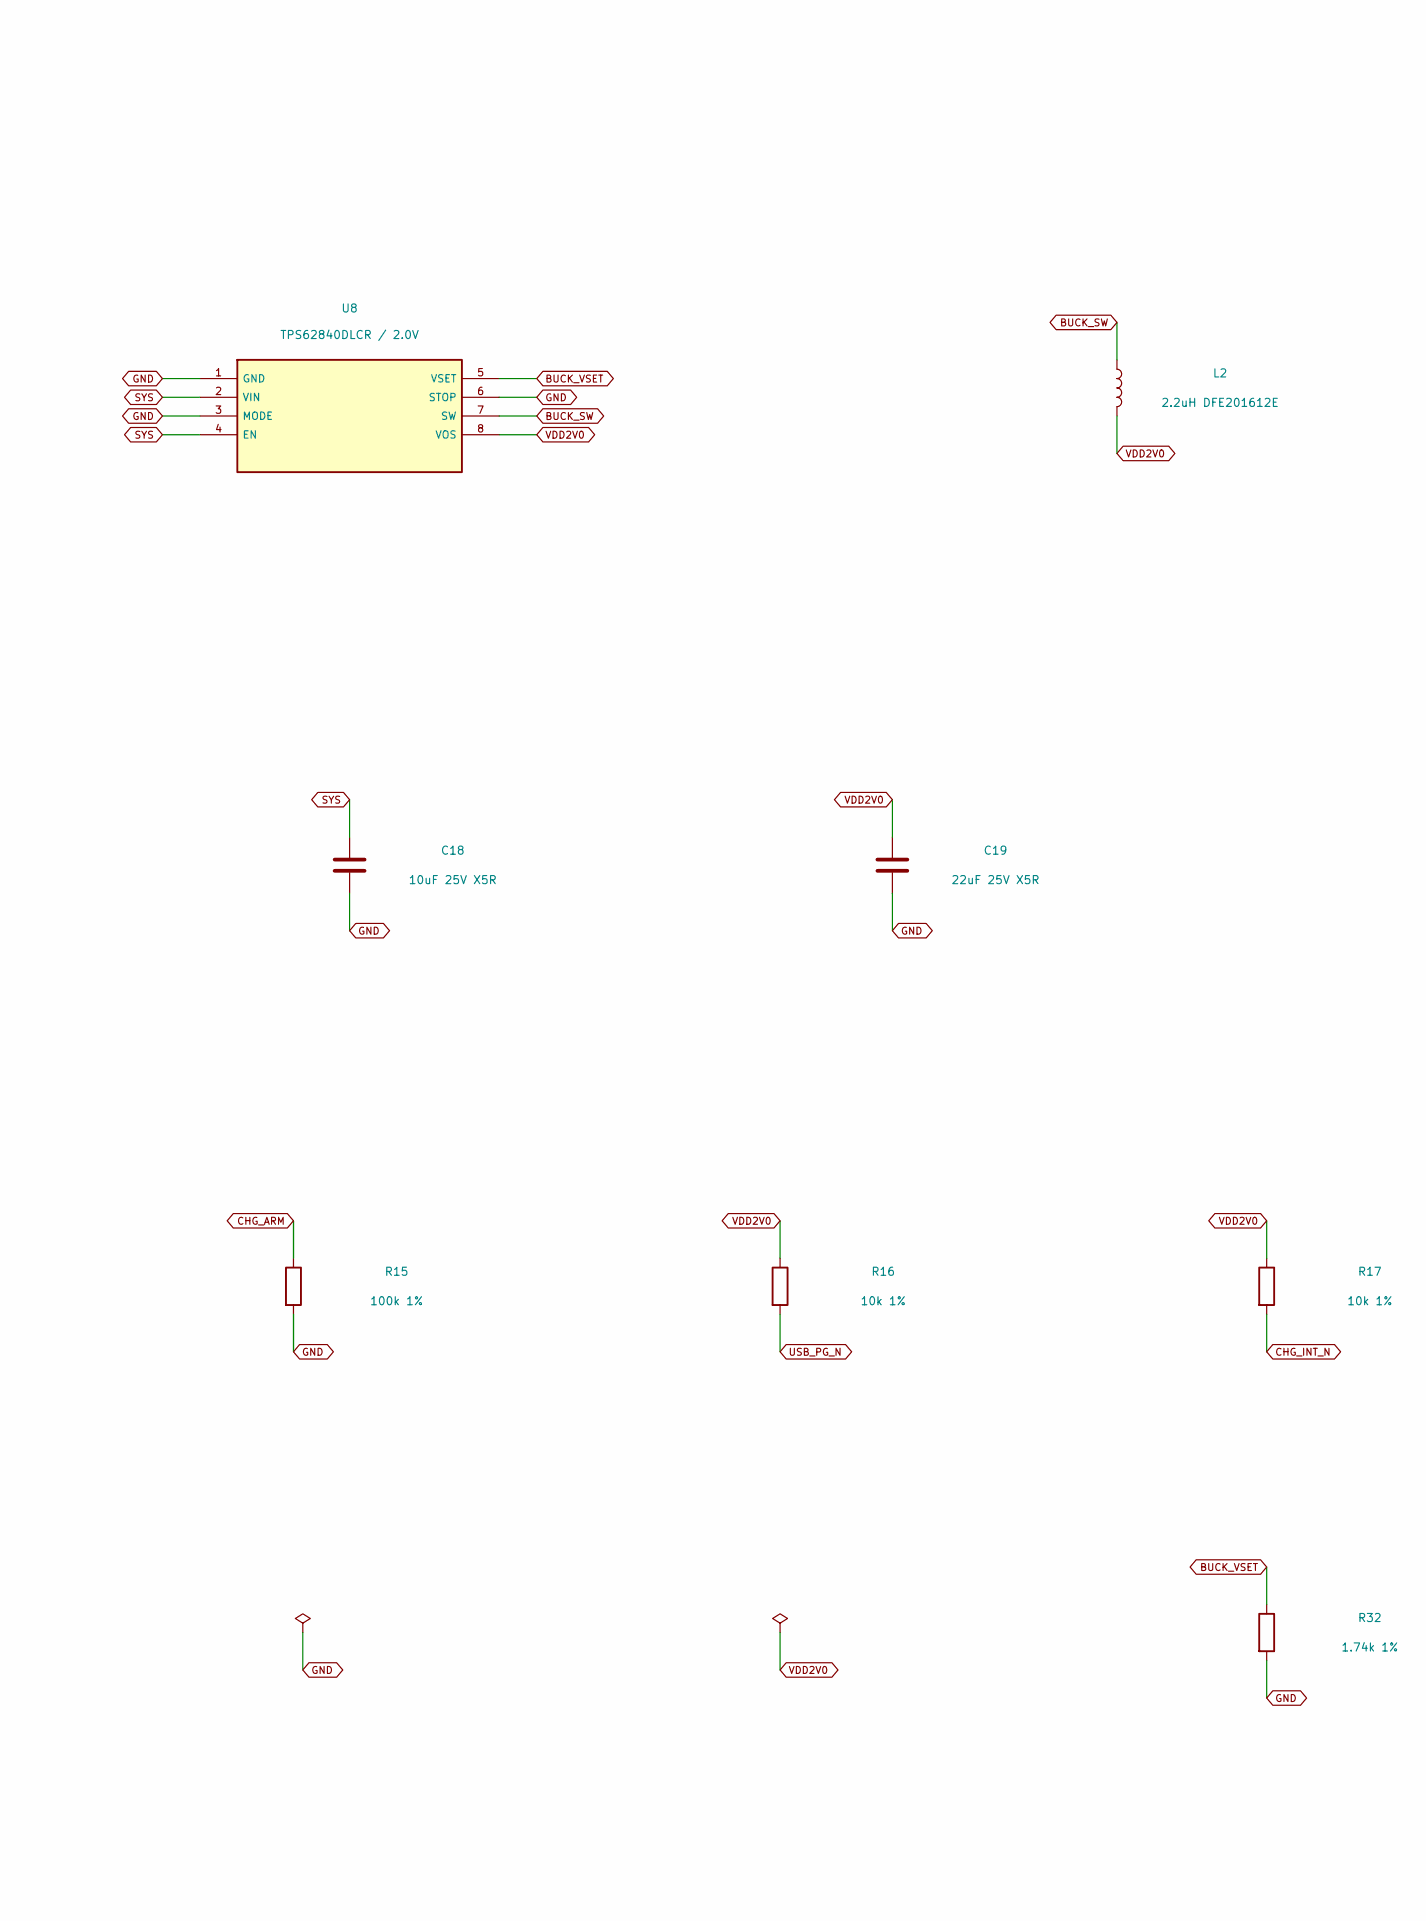
[picture p8: schematic Circuit_04.kicad_sch, Charger and system 2.0V rail, part in row 1, column 2]

Parts:
C15, C17: 4.7uF 25V X5R; C_0603_1608Metric; MPN C1608X5R1E475K080AC
C16, C19: 22uF 25V X5R; C_0805_2012Metric; MPN C2012X5R1E226M125AC
C18: 10uF 25V X5R; C_0805_2012Metric; MPN C2012X5R1E106K125AB
L2: 2.2uH DFE201612E; L_DFE201612E_DS; MPN DFE201612E-2R2M=P2
Q2: DMN1019USN-7; SC-59; MPN DMN1019USN-7
R12, R15: 100k 1%; R_0402_1005Metric; MPN RC0402FR-07100KL
R16, R17: 10k 1%; R_0402_1005Metric; MPN RC0402FR-0710KL
R32: 1.74k 1%; R_0402_1005Metric; MPN RC0402FR-071K74L
SW2: B3U-1000P / POWER; SW_SPST_B3U-1000P; MPN B3U-1000P
U7: BQ25186DLHR / 0x6A; Texas_DLH0010A_WSON-10-1EP_2.2x2mm_P0.4mm_EP0.9x1.5mm; MPN BQ25186DLHR
U8: TPS62840DLCR / 2.0V; Texas_VSON-HR-8_1.5x2mm_P0.5mm; MPN TPS62840DLCR

Connections:
BAT_TS: SW2.1, U7.6 (TS/MR); also elsewhere on the board
BUCK_SW: L2.1, U8.7 (SW)
BUCK_VSET: R32.1, U8.5 (VSET)
CHG_ARM: Q2.1 (G), R15.1; also elsewhere on the board
CHG_CE_N: Q2.3 (D), R12.2, U7.4 (~CE)
CHG_INT_N: R17.2, U7.9 (~INT); also elsewhere on the board
GND: C15.2, C16.2, C17.2, C18.2, C19.2, Q2.2 (S), R15.2, R32.2, SW2.2, U7.5 (GND), U7.11 (EP_GND), U8.1 (GND), U8.3 (MODE), U8.6 (STOP); also elsewhere on the board
I2C_SCL: U7.8 (SCL); also elsewhere on the board
I2C_SDA: U7.7 (SDA); also elsewhere on the board
SYS: C16.1, C18.1, R12.1, U7.1 (SYS), U8.2 (VIN), U8.4 (EN); also elsewhere on the board
USB5V: C15.1, U7.10 (IN); also elsewhere on the board
USB_PG_N: R16.2, U7.3 (~PG/GPO); also elsewhere on the board
VBAT: C17.1, U7.2 (BAT); also elsewhere on the board
VDD2V0: C19.1, L2.2, R16.1, R17.1, U8.8 (VOS); also elsewhere on the board

Notes on the sheet:
04 / Charger and system 2.0V rail
Reset defaults: Q2 off /CE high (charge disabled). Configure 4.20V /30mA/NTC HOT45C+COLD5C before CHG_ARM.
Retain TS protection and charger watchdog. Set USB input limit50mA unless host/source permits more.
SYS is about battery voltage or charger-regulated4.5V: never connect directly to MCU/IMU.
VSET via R32=1.74k to GND selects 2.0V. MODE/STOP=GND; VOS is AFTER L2.
