shjoo0407/SentiFrame/HW/SentiFrame.kicad_pcb

## KiCad design HW/SentiFrame.kicad_pcb (continued)

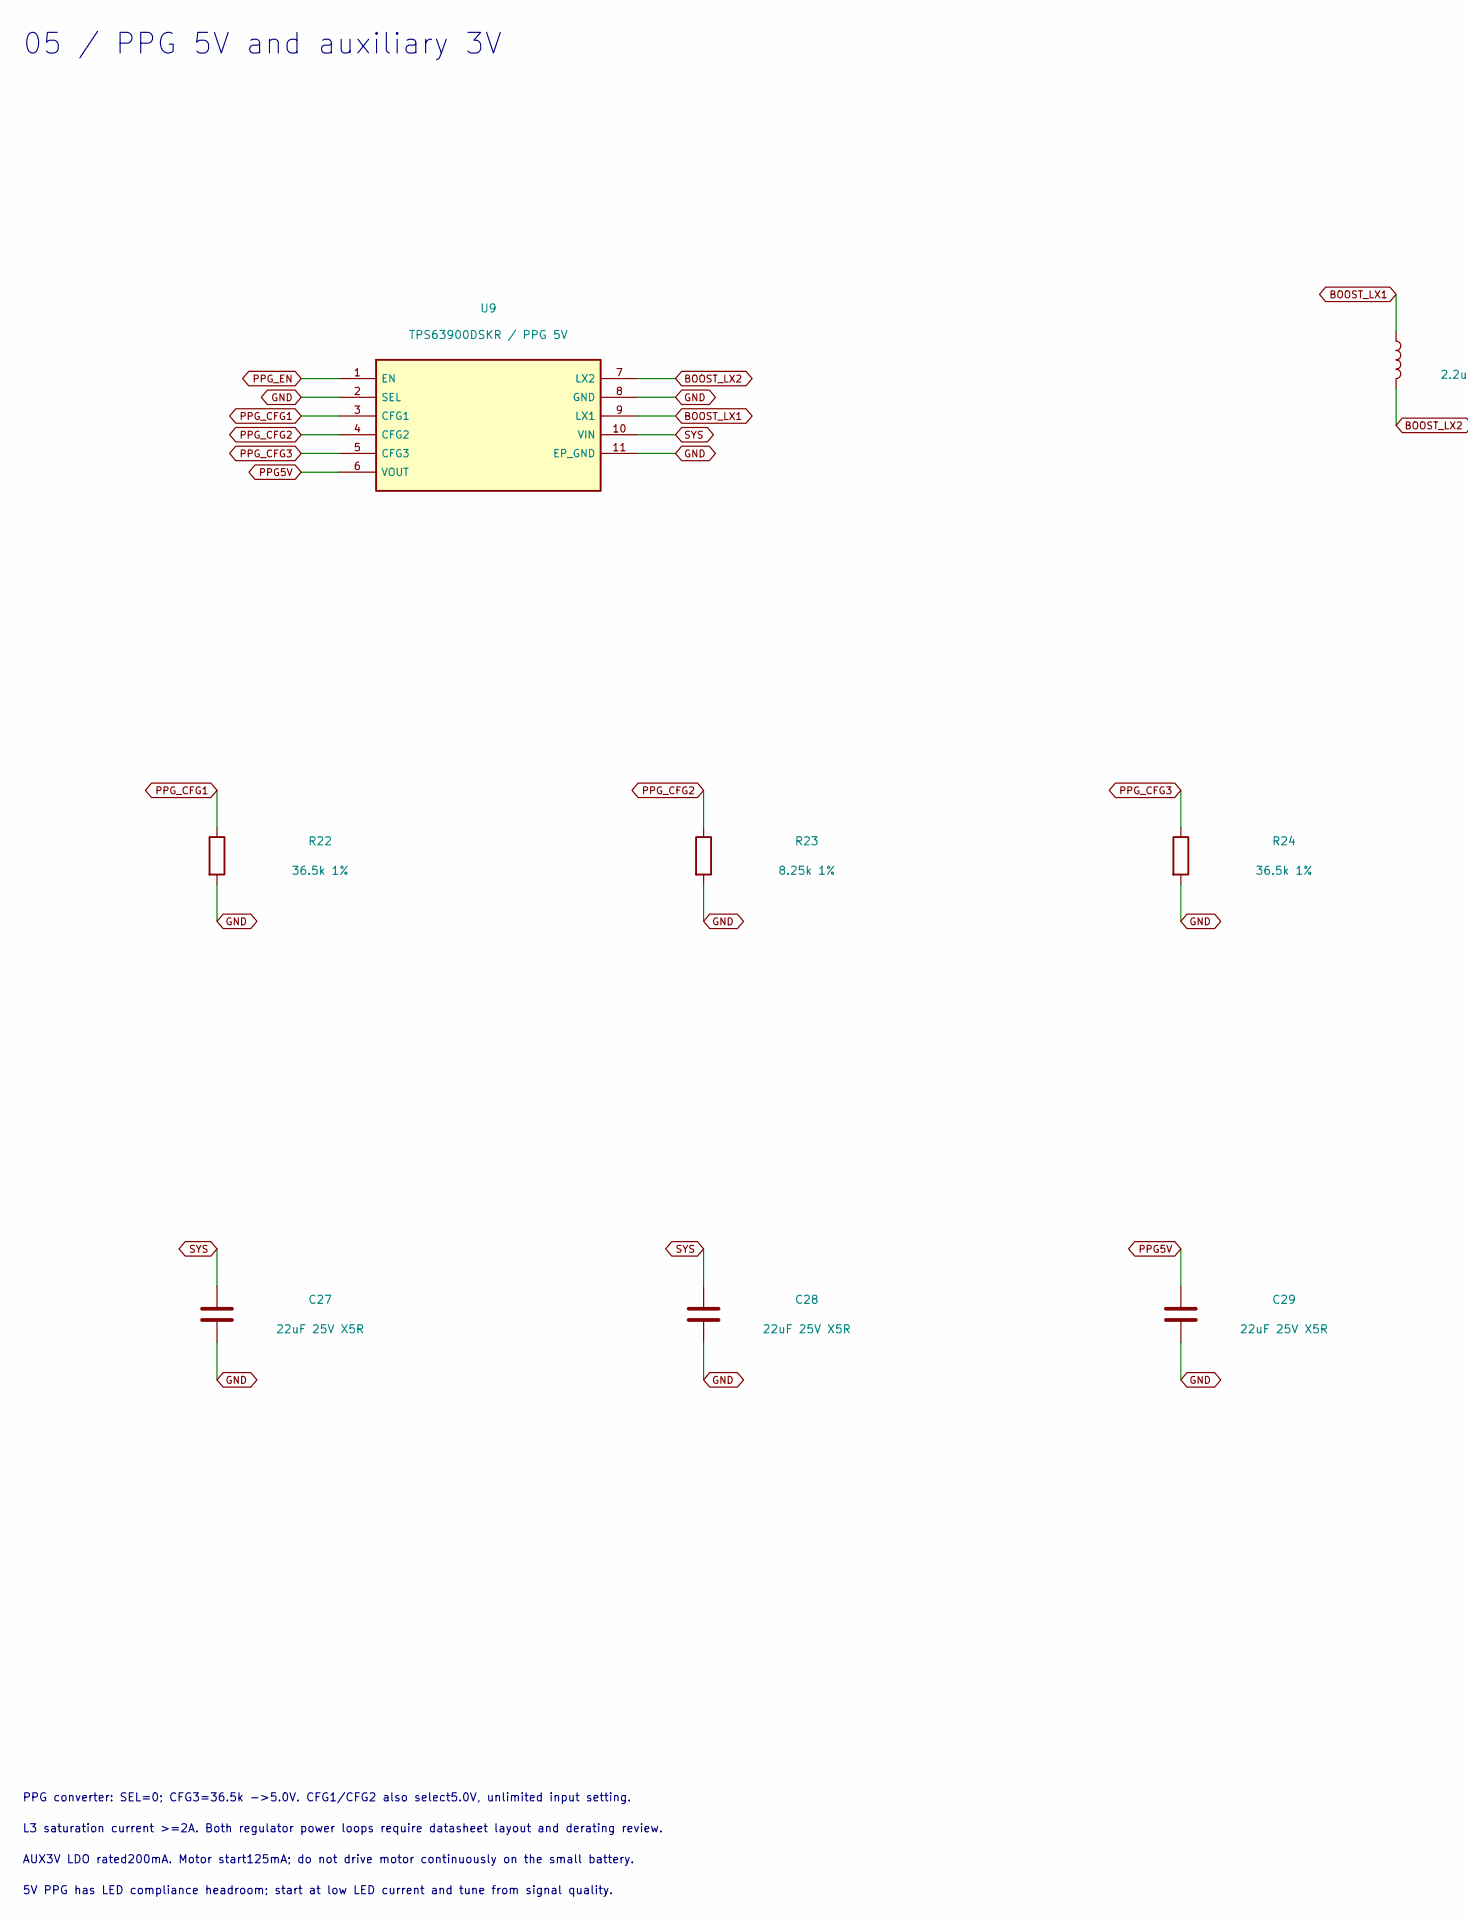
[picture p9: schematic Circuit_05.kicad_sch, PPG 5V and auxiliary 3V, part in row 1, column 1]

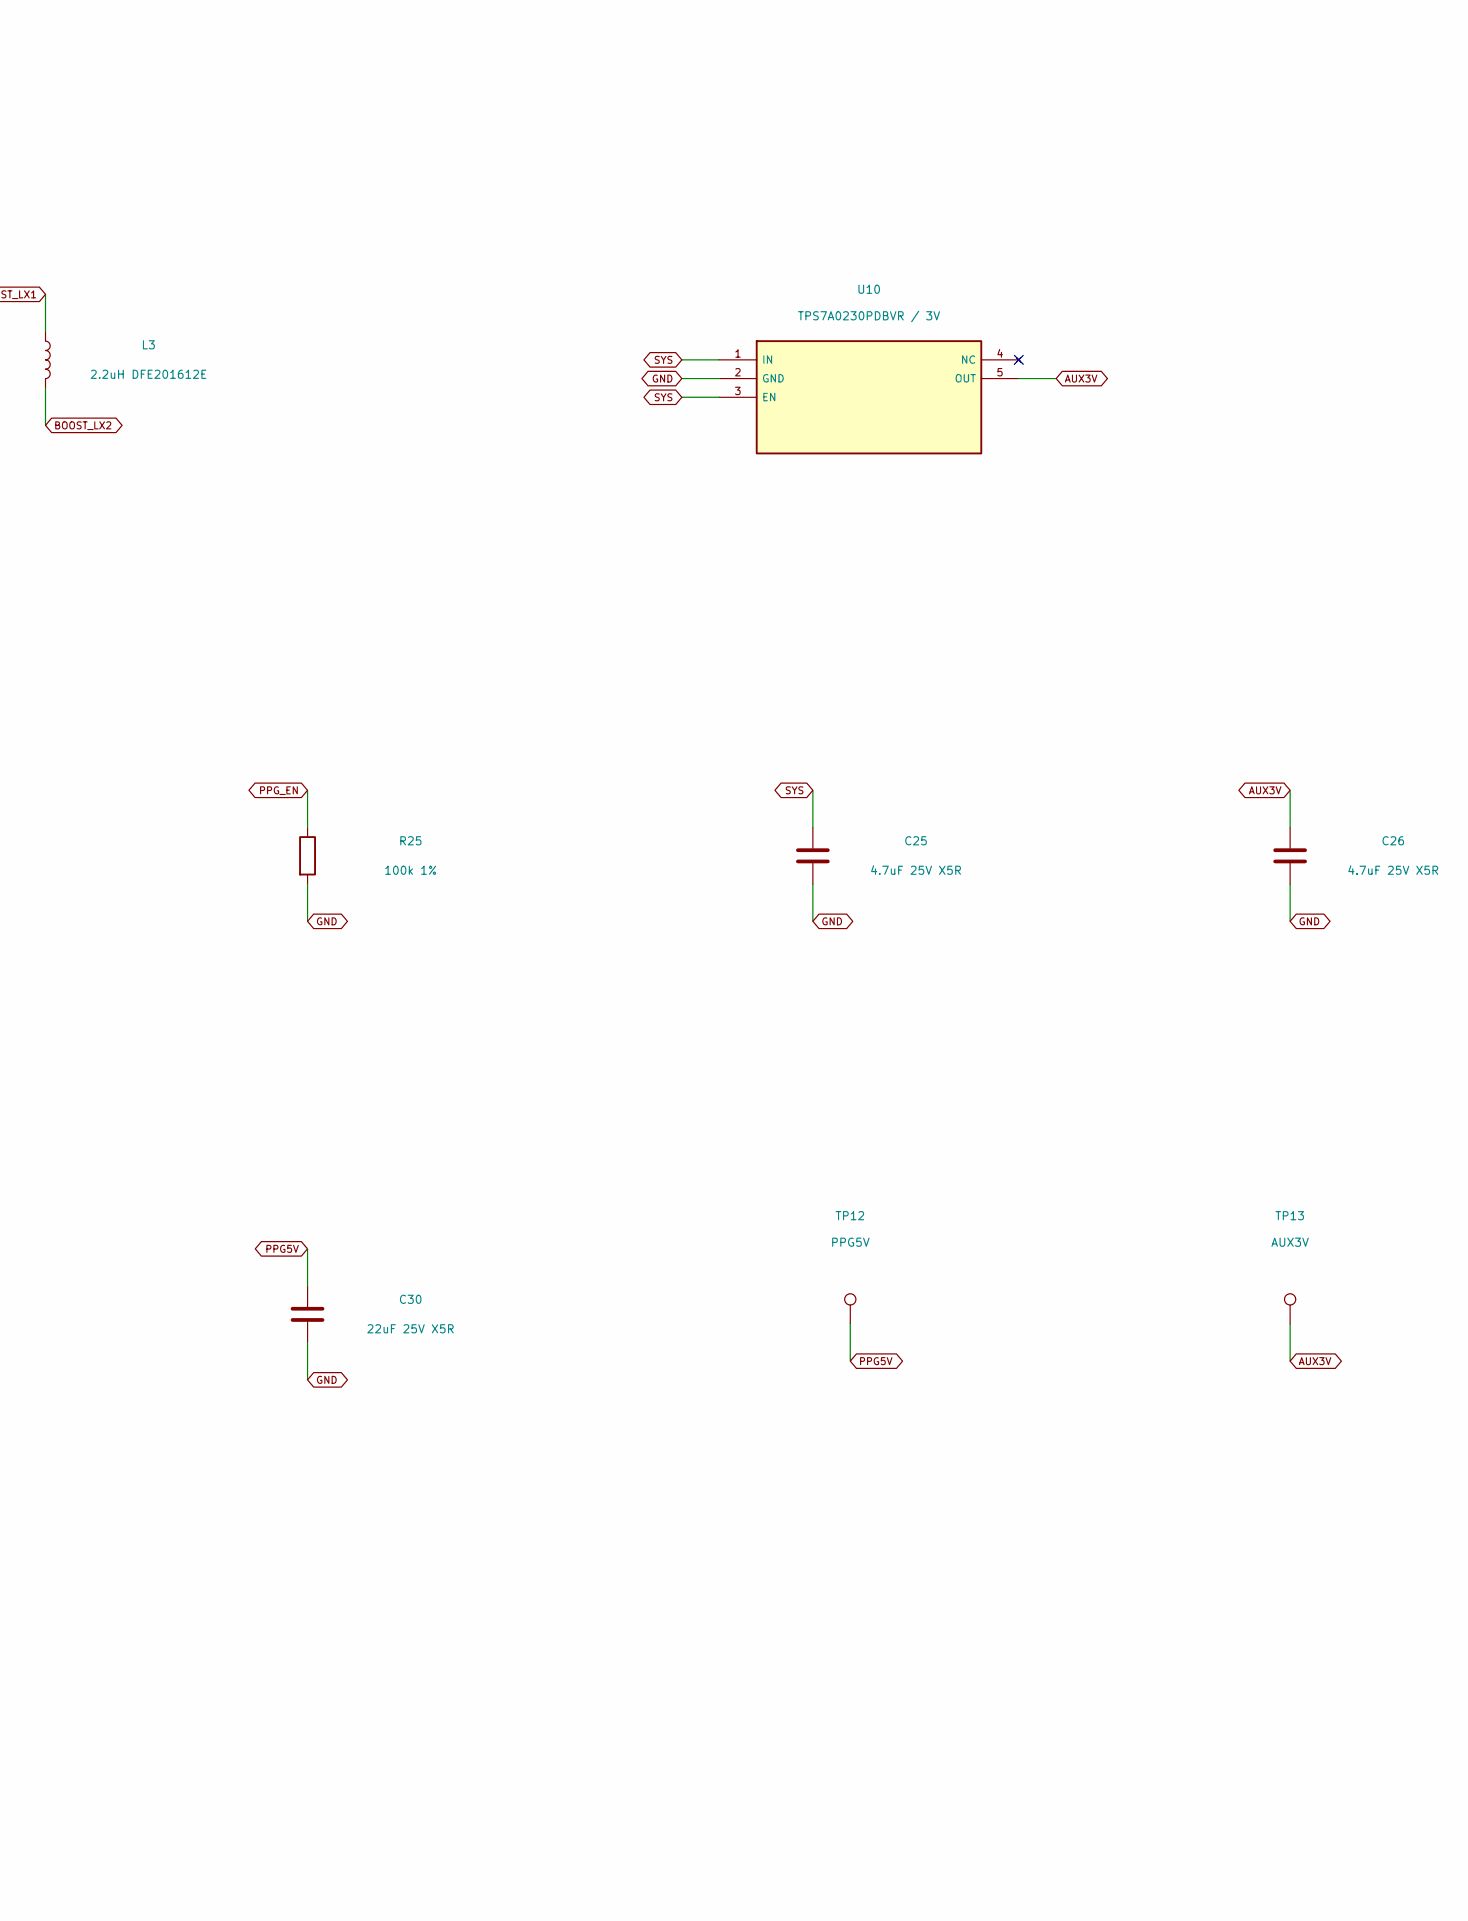
[picture p10: schematic Circuit_05.kicad_sch, PPG 5V and auxiliary 3V, part in row 1, column 2]

Parts:
C25, C26: 4.7uF 25V X5R; C_0603_1608Metric; MPN C1608X5R1E475K080AC
C27, C28, C29, C30: 22uF 25V X5R; C_0805_2012Metric; MPN C2012X5R1E226M125AC
L3: 2.2uH DFE201612E; L_DFE201612E_DS; MPN DFE201612E-2R2M=P2
R22, R24: 36.5k 1%; R_0402_1005Metric; MPN RC0402FR-0736K5L
R23: 8.25k 1%; R_0402_1005Metric; MPN RC0402FR-078K25L
R25: 100k 1%; R_0402_1005Metric; MPN RC0402FR-07100KL
TP12: PPG5V; TestPoint_Pad_D1.0mm
TP13: AUX3V; TestPoint_Pad_D1.0mm
U9: TPS63900DSKR / PPG 5V; WSON-10-1EP_2.5x2.5mm_P0.5mm_EP1.2x2mm; MPN TPS63900DSKR
U10: TPS7A0230PDBVR / 3V; SOT-23-5; MPN TPS7A0230PDBVR

Connections:
AUX3V: C26.1, TP13.1, U10.5 (OUT); also elsewhere on the board
BOOST_LX1: L3.1, U9.9 (LX1)
BOOST_LX2: L3.2, U9.7 (LX2)
GND: C25.2, C26.2, C27.2, C28.2, C29.2, C30.2, R22.2, R23.2, R24.2, R25.2, U9.2 (SEL), U9.8 (GND), U9.11 (EP_GND), U10.2 (GND); also elsewhere on the board
PPG5V: C29.1, C30.1, TP12.1, U9.6 (VOUT); also elsewhere on the board
PPG_CFG1: R22.1, U9.3 (CFG1)
PPG_CFG2: R23.1, U9.4 (CFG2)
PPG_CFG3: R24.1, U9.5 (CFG3)
PPG_EN: R25.1, U9.1 (EN); also elsewhere on the board
SYS: C25.1, C27.1, C28.1, U9.10 (VIN), U10.1 (IN), U10.3 (EN); also elsewhere on the board

Notes on the sheet:
05 / PPG 5V and auxiliary 3V
PPG converter: SEL=0; CFG3=36.5k ->5.0V. CFG1/CFG2 also select5.0V, unlimited input setting.
L3 saturation current >=2A. Both regulator power loops require datasheet layout and derating review.
AUX3V LDO rated200mA. Motor start125mA; do not drive motor continuously on the small battery.
5V PPG has LED compliance headroom; start at low LED current and tune from signal quality.

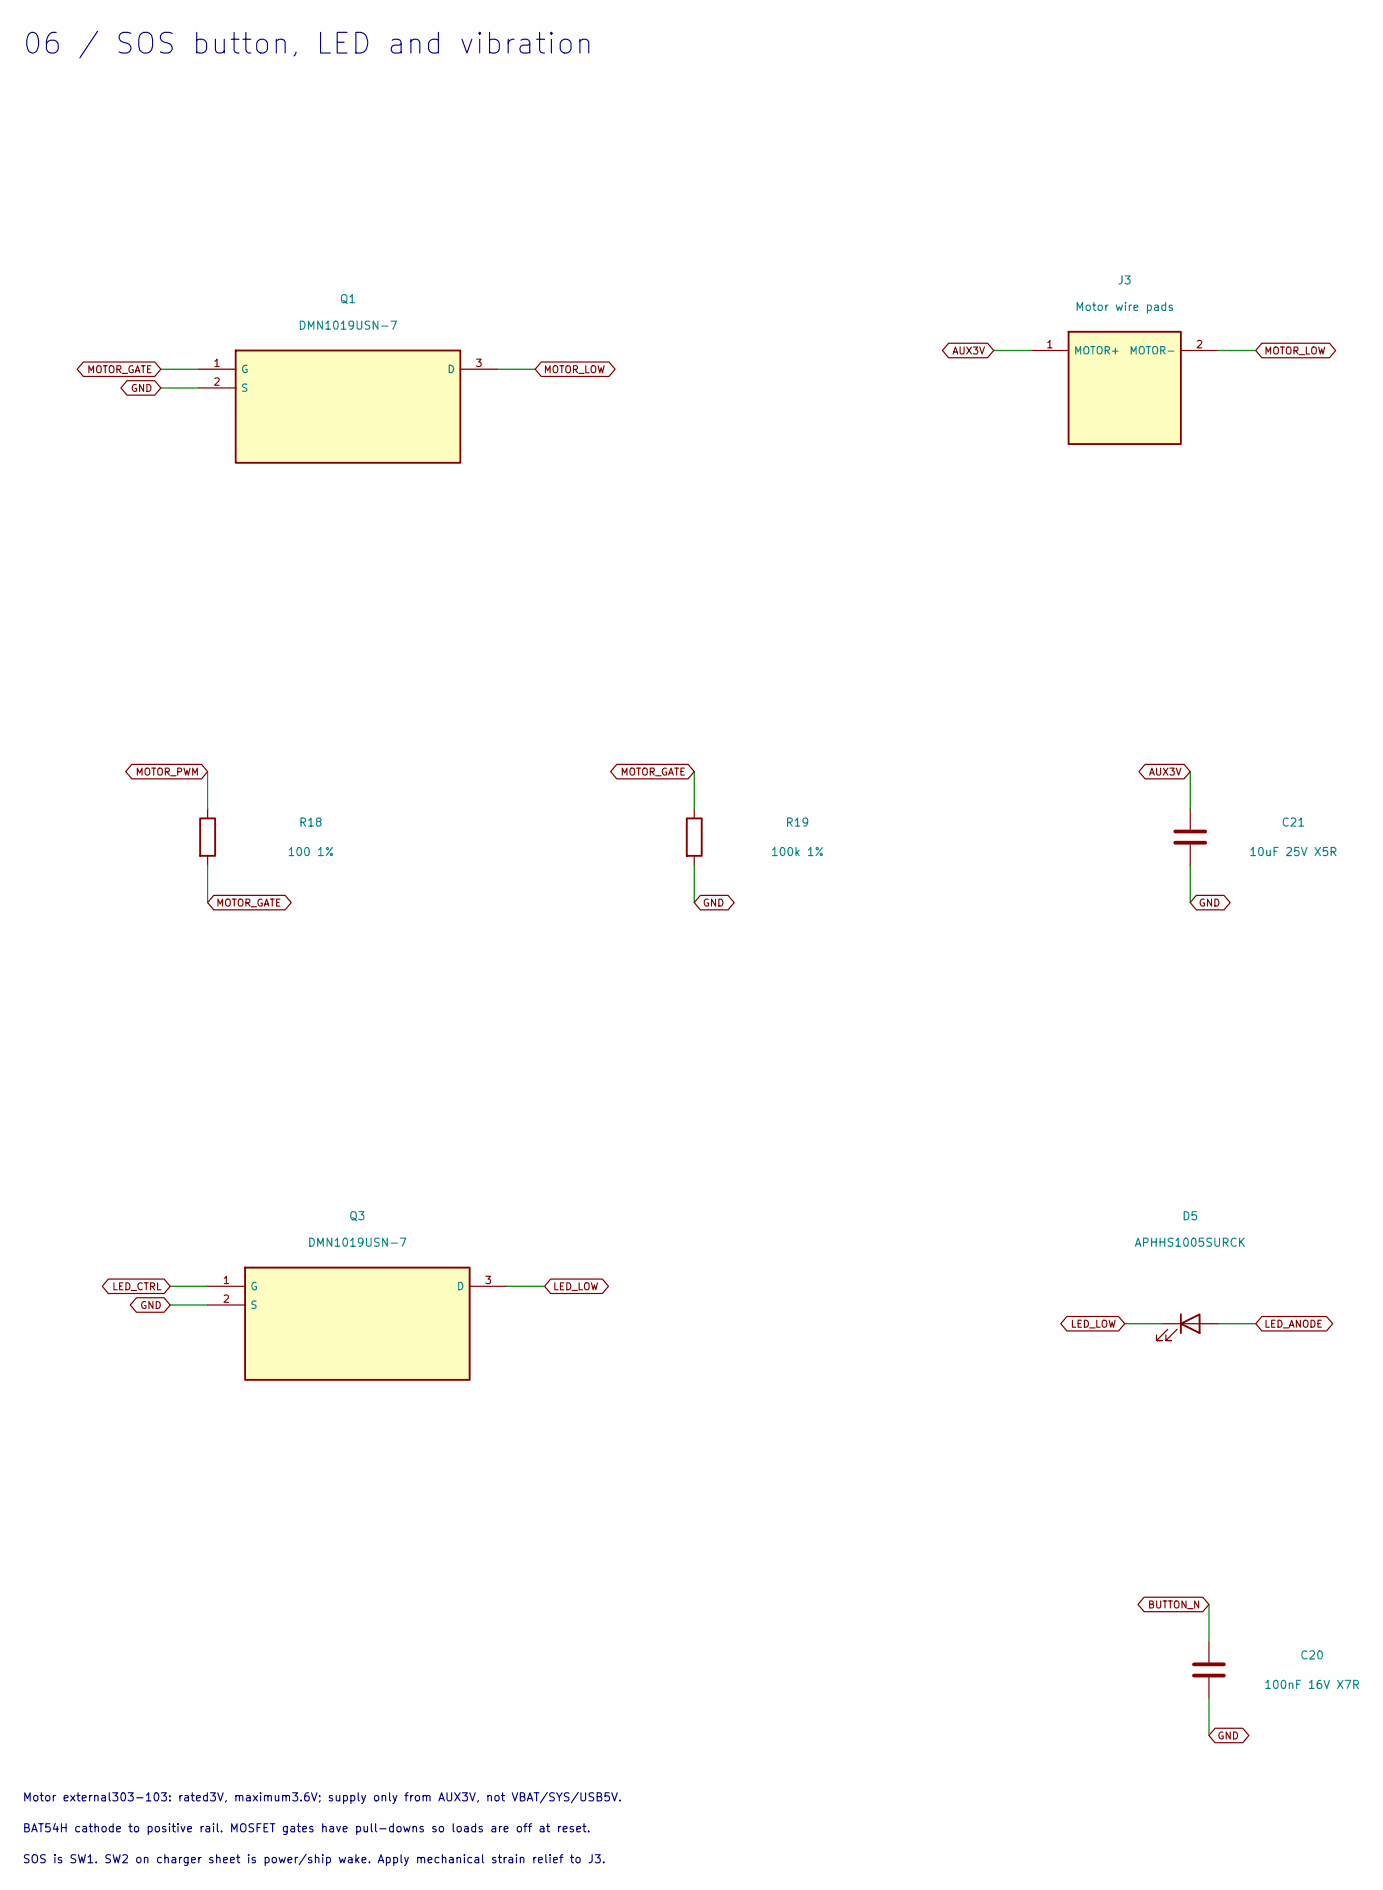
[picture p11: schematic Circuit_06.kicad_sch, SOS button, LED and vibration, part in row 1, column 1]

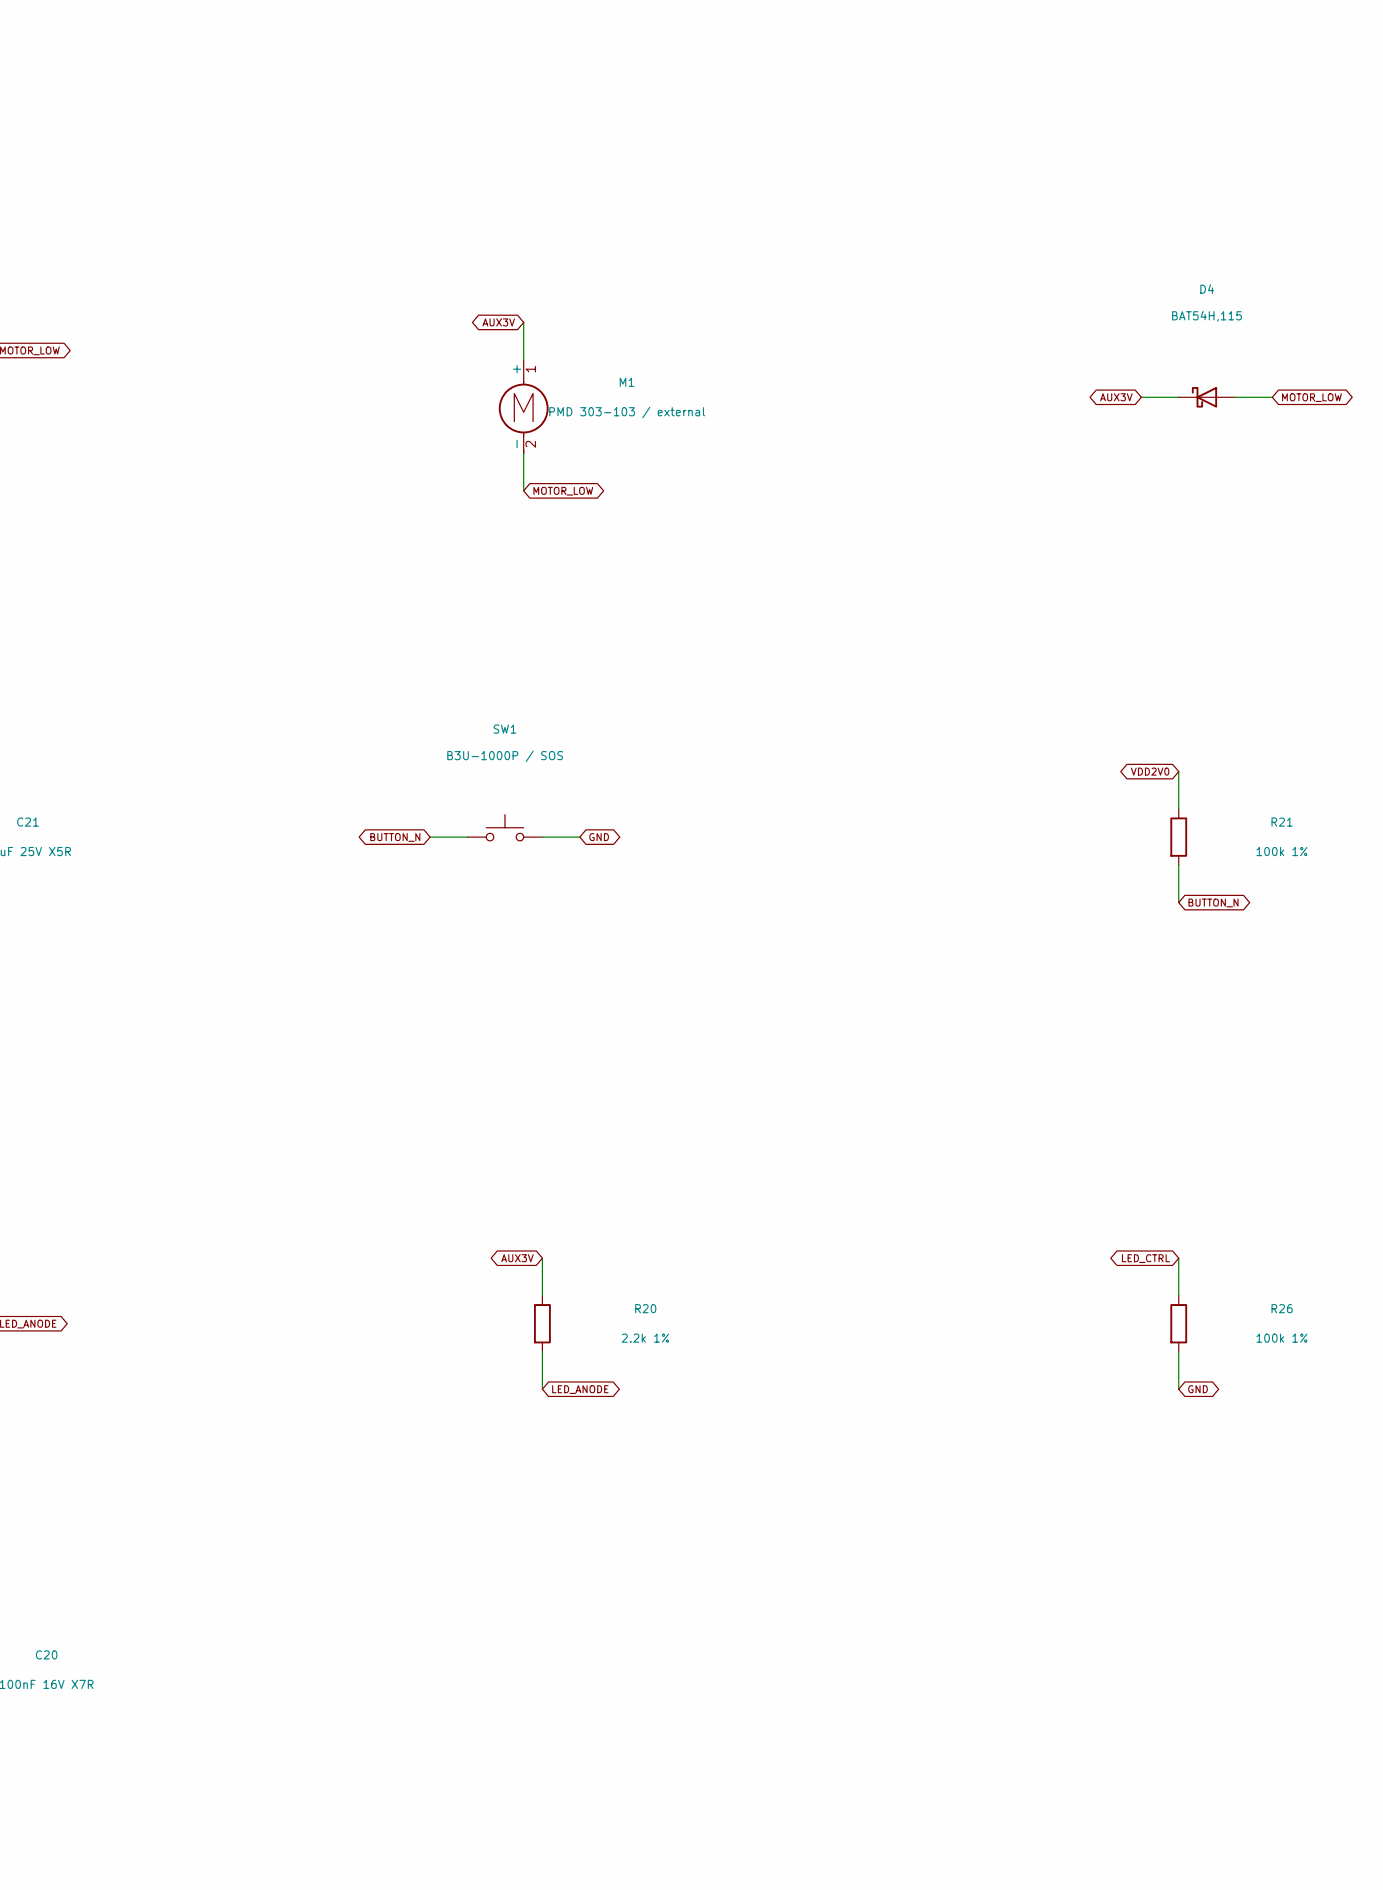
[picture p12: schematic Circuit_06.kicad_sch, SOS button, LED and vibration, part in row 1, column 2]

Parts:
C20: 100nF 16V X7R; C_0402_1005Metric; MPN C1005X7R1C104K050BC
C21: 10uF 25V X5R; C_0805_2012Metric; MPN C2012X5R1E106K125AB
D4: BAT54H,115; D_SOD-123F; MPN BAT54H,115
D5: APHHS1005SURCK; LED_0402_1005Metric; MPN APHHS1005SURCK
J3: Motor wire pads; Motor_Wire_Pads_2P
M1: PMD 303-103 / external; MPN 303-103
Q1, Q3: DMN1019USN-7; SC-59; MPN DMN1019USN-7
R18: 100 1%; R_0402_1005Metric; MPN RC0402FR-07100RL
R19, R21, R26: 100k 1%; R_0402_1005Metric; MPN RC0402FR-07100KL
R20: 2.2k 1%; R_0402_1005Metric; MPN RC0402FR-072K2L
SW1: B3U-1000P / SOS; SW_SPST_B3U-1000P; MPN B3U-1000P

Connections:
AUX3V: C21.1, D4.1 (K), J3.1 (MOTOR+), M1.1 (+), R20.1; also elsewhere on the board
BUTTON_N: C20.1, R21.2, SW1.1; also elsewhere on the board
GND: C20.2, C21.2, Q1.2 (S), Q3.2 (S), R19.2, R26.2, SW1.2; also elsewhere on the board
LED_ANODE: D5.2 (A), R20.2
LED_CTRL: Q3.1 (G), R26.1; also elsewhere on the board
LED_LOW: D5.1 (K), Q3.3 (D)
MOTOR_GATE: Q1.1 (G), R18.2, R19.1
MOTOR_LOW: D4.2 (A), J3.2 (MOTOR-), M1.2 (-), Q1.3 (D)
MOTOR_PWM: R18.1; also elsewhere on the board
VDD2V0: R21.1; also elsewhere on the board

Notes on the sheet:
06 / SOS button, LED and vibration
Motor external303-103: rated3V, maximum3.6V; supply only from AUX3V, not VBAT/SYS/USB5V.
BAT54H cathode to positive rail. MOSFET gates have pull-downs so loads are off at reset.
SOS is SW1. SW2 on charger sheet is power/ship wake. Apply mechanical strain relief to J3.

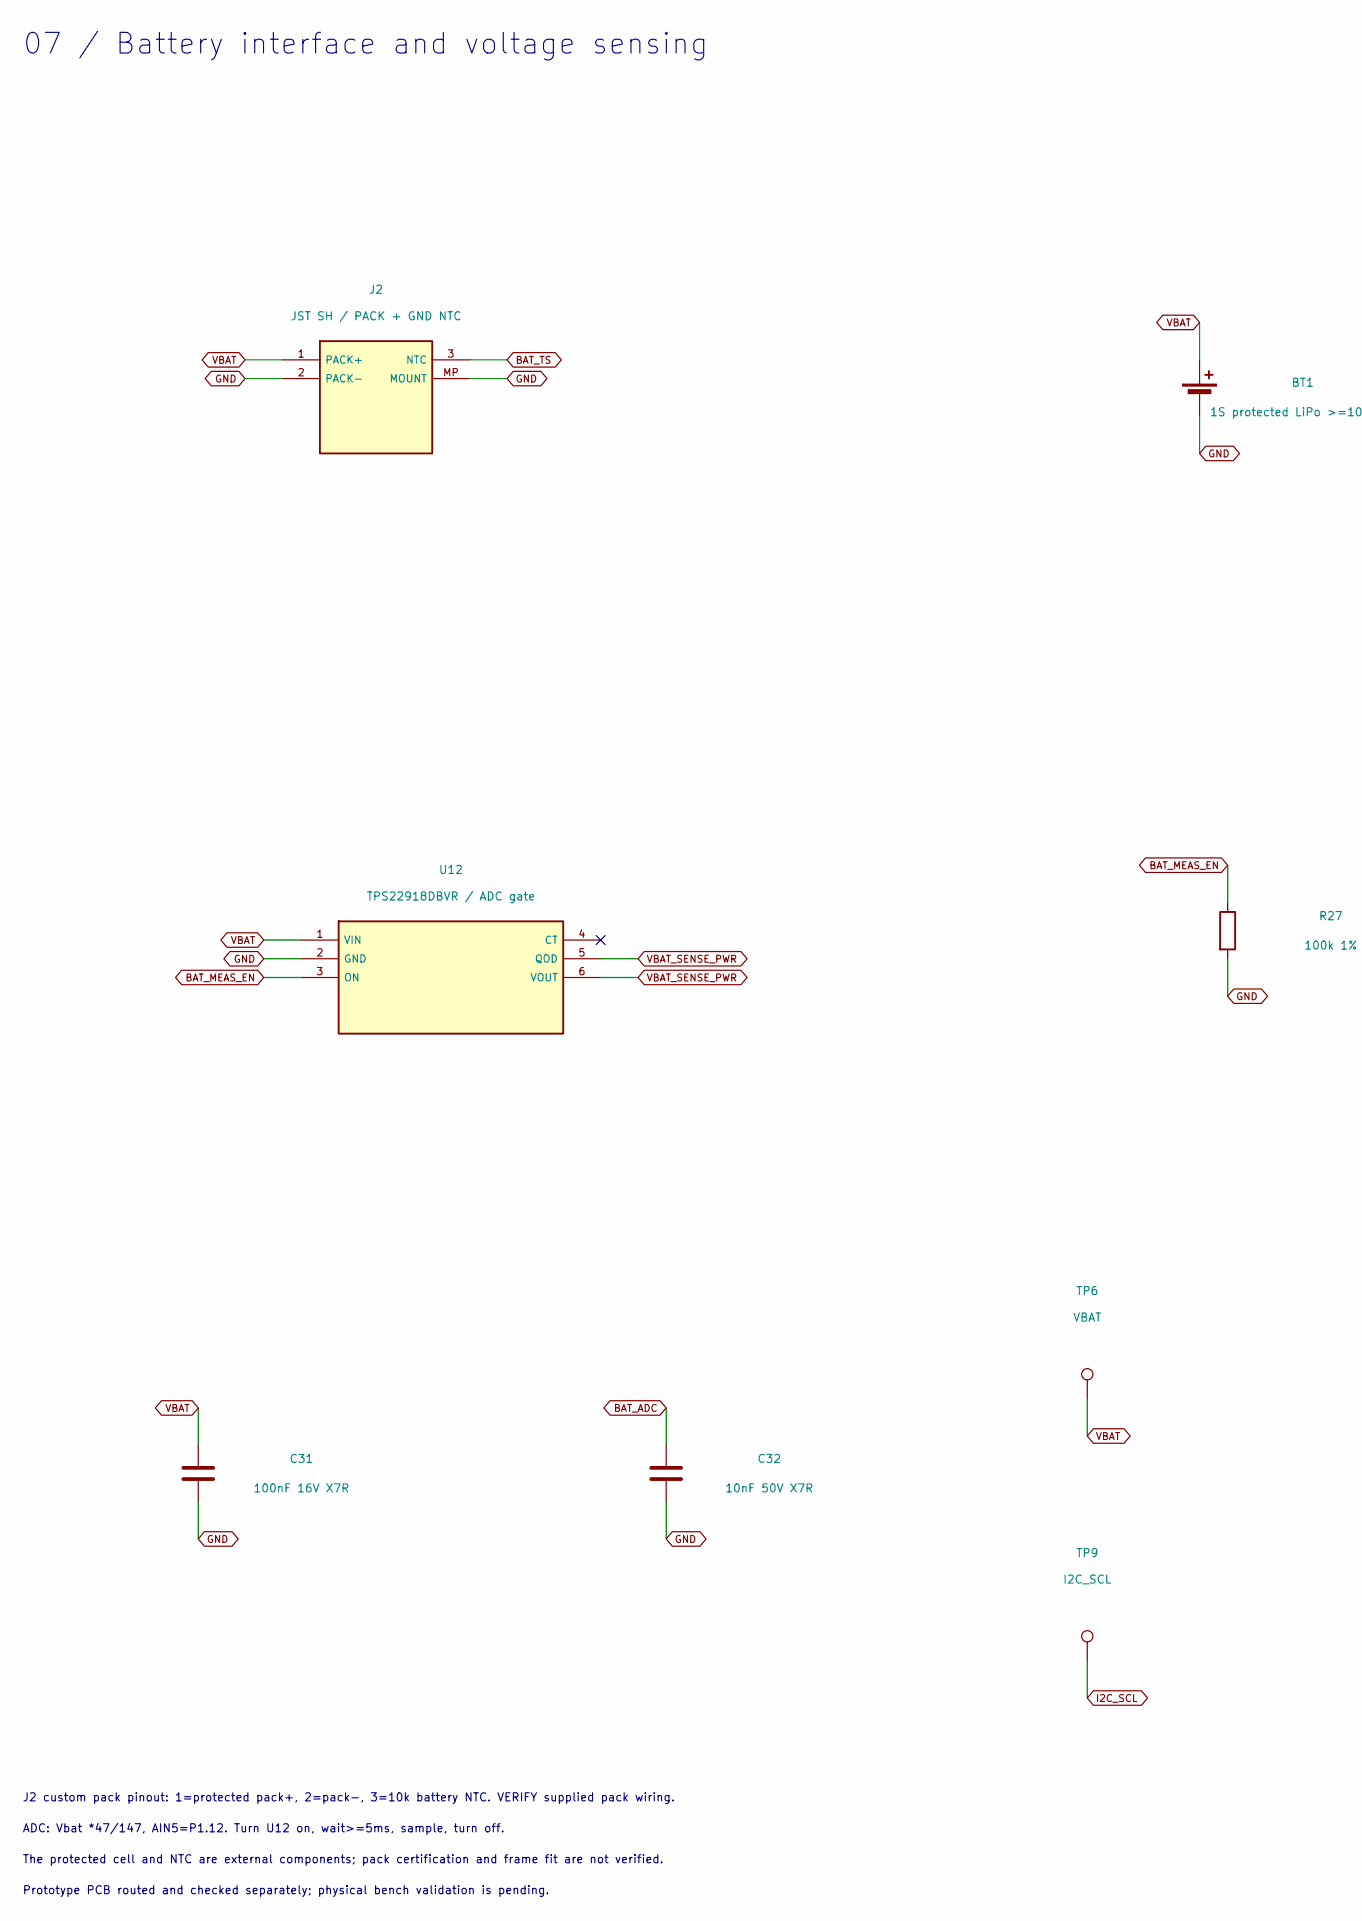
[picture p13: schematic Circuit_07.kicad_sch, Battery interface and voltage sensing, part in row 1, column 1]

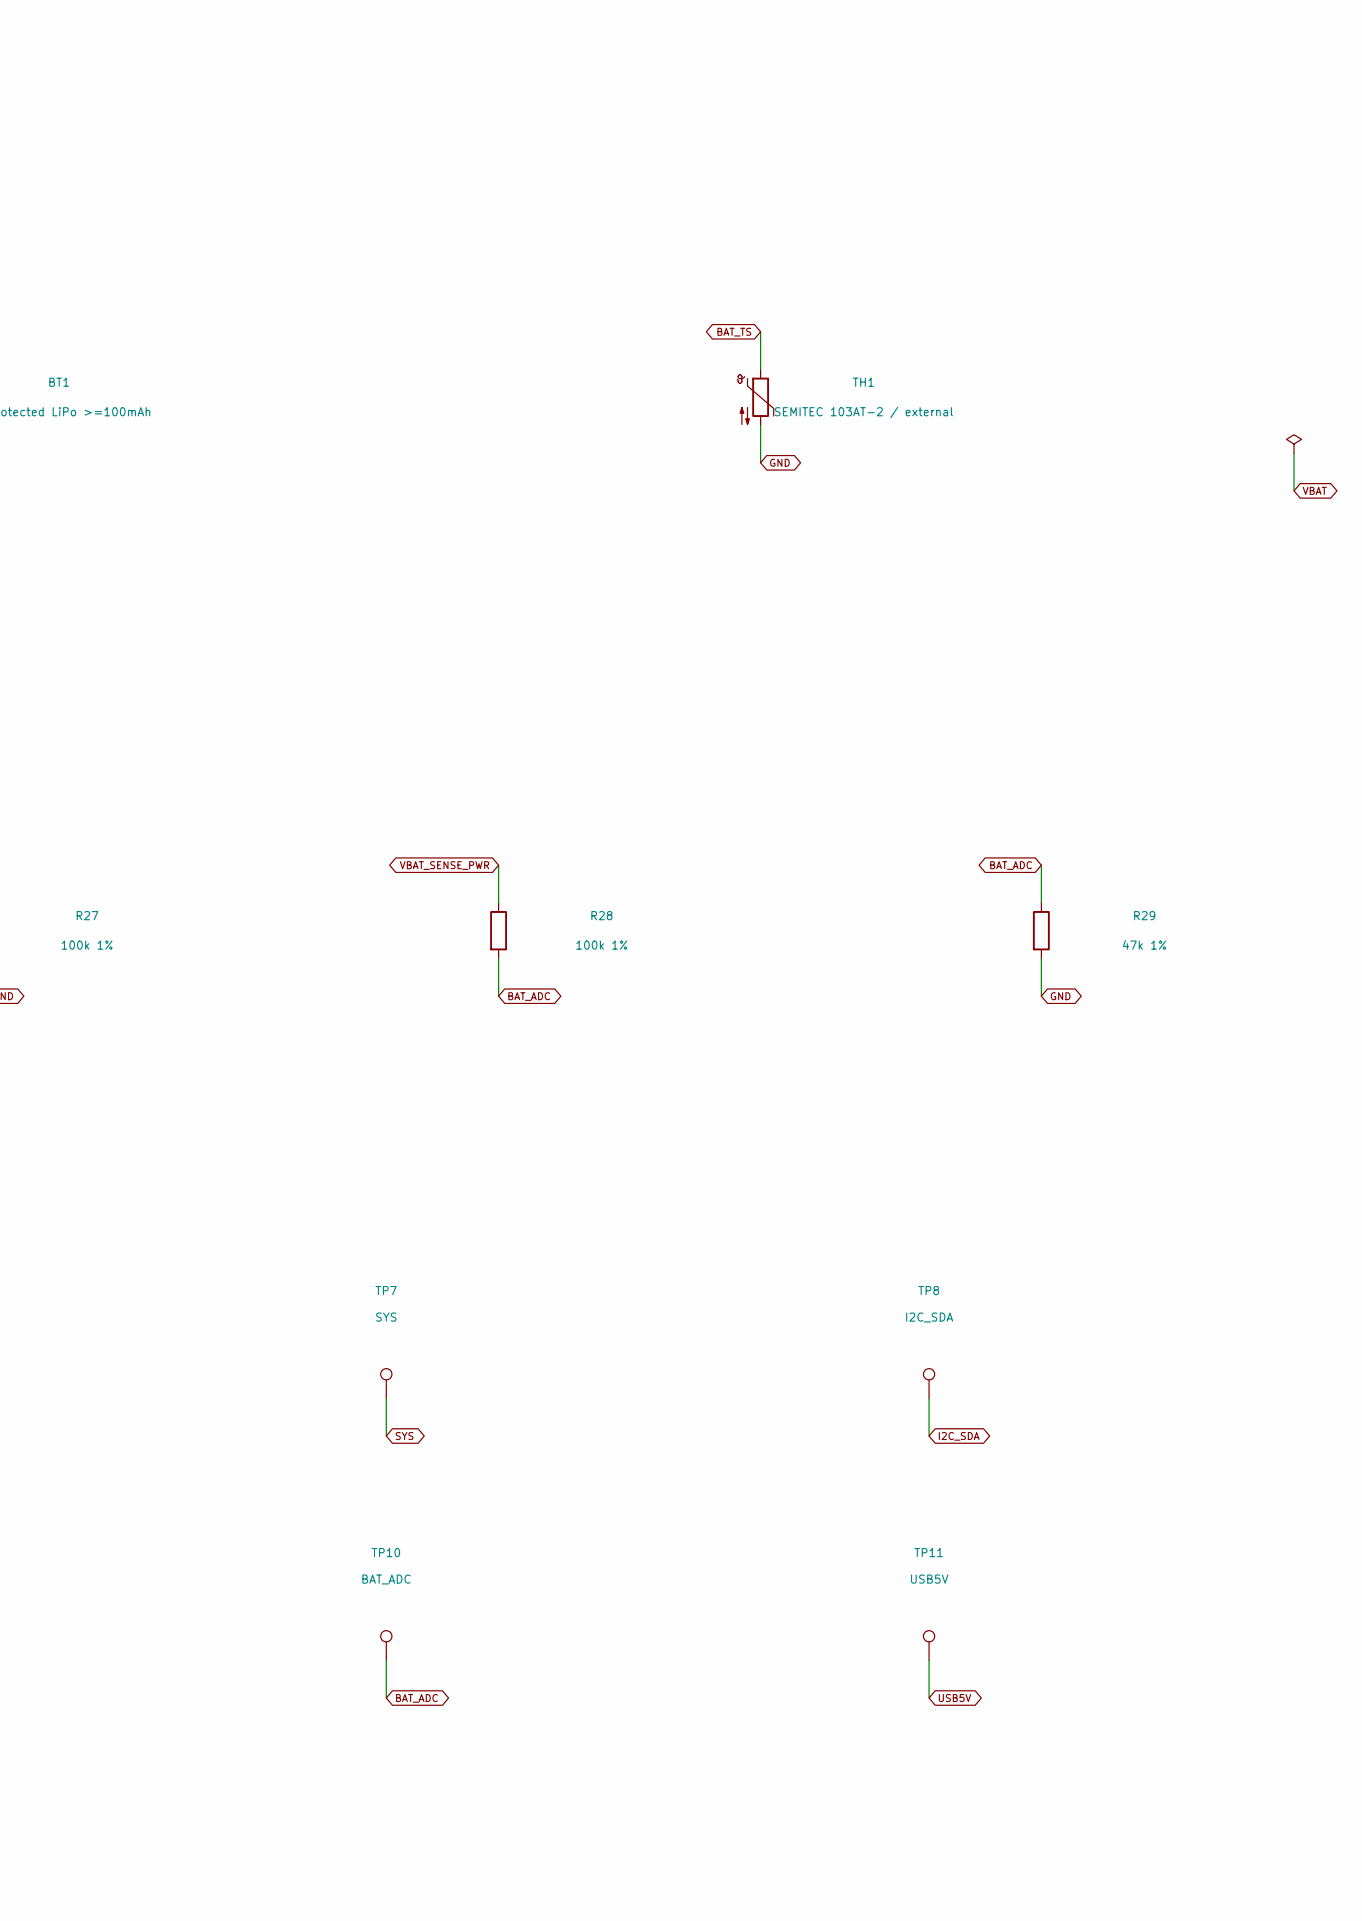
[picture p14: schematic Circuit_07.kicad_sch, Battery interface and voltage sensing, part in row 1, column 2]

Parts:
BT1: 1S protected LiPo >=100mAh; MPN SF-PACK-001 interface specification
C31: 100nF 16V X7R; C_0402_1005Metric; MPN C1005X7R1C104K050BC
C32: 10nF 50V X7R; C_0402_1005Metric; MPN C1005X7R1H103K050BB
J2: JST SH / PACK + GND NTC; JST_SH_SM03B-SRSS-TB_1x03-1MP_P1.00mm_Horizontal; MPN SM03B-SRSS-TB
R27, R28: 100k 1%; R_0402_1005Metric; MPN RC0402FR-07100KL
R29: 47k 1%; R_0402_1005Metric; MPN RC0402FR-0747KL
TH1: SEMITEC 103AT-2 / external; MPN 103AT-2
TP6: VBAT; TestPoint_Pad_D1.0mm
TP7: SYS; TestPoint_Pad_D1.0mm
TP8: I2C_SDA; TestPoint_Pad_D1.0mm
TP9: I2C_SCL; TestPoint_Pad_D1.0mm
TP10: BAT_ADC; TestPoint_Pad_D1.0mm
TP11: USB5V; TestPoint_Pad_D1.0mm
U12: TPS22918DBVR / ADC gate; SOT-23-6; MPN TPS22918DBVR

Connections:
BAT_ADC: C32.1, R28.2, R29.1, TP10.1; also elsewhere on the board
BAT_MEAS_EN: R27.1, U12.3 (ON); also elsewhere on the board
BAT_TS: J2.3 (NTC), TH1.1; also elsewhere on the board
GND: BT1.2 (-), C31.2, C32.2, J2.2 (PACK-), J2.MP (MOUNT), R27.2, R29.2, TH1.2, U12.2 (GND); also elsewhere on the board
I2C_SCL: TP9.1; also elsewhere on the board
I2C_SDA: TP8.1; also elsewhere on the board
SYS: TP7.1; also elsewhere on the board
USB5V: TP11.1; also elsewhere on the board
VBAT: BT1.1 (+), C31.1, J2.1 (PACK+), TP6.1, U12.1 (VIN); also elsewhere on the board
VBAT_SENSE_PWR: R28.1, U12.5 (QOD), U12.6 (VOUT)

Notes on the sheet:
07 / Battery interface and voltage sensing
J2 custom pack pinout: 1=protected pack+, 2=pack-, 3=10k battery NTC. VERIFY supplied pack wiring.
ADC: Vbat *47/147, AIN5=P1.12. Turn U12 on, wait>=5ms, sample, turn off.
The protected cell and NTC are external components; pack certification and frame fit are not verified.
Prototype PCB routed and checked separately; physical bench validation is pending.
