shjoo0407/SentiFrame/HW/SentiFrame.kicad_pcb

## KiCad design HW/SentiFrame.kicad_pcb (continued)

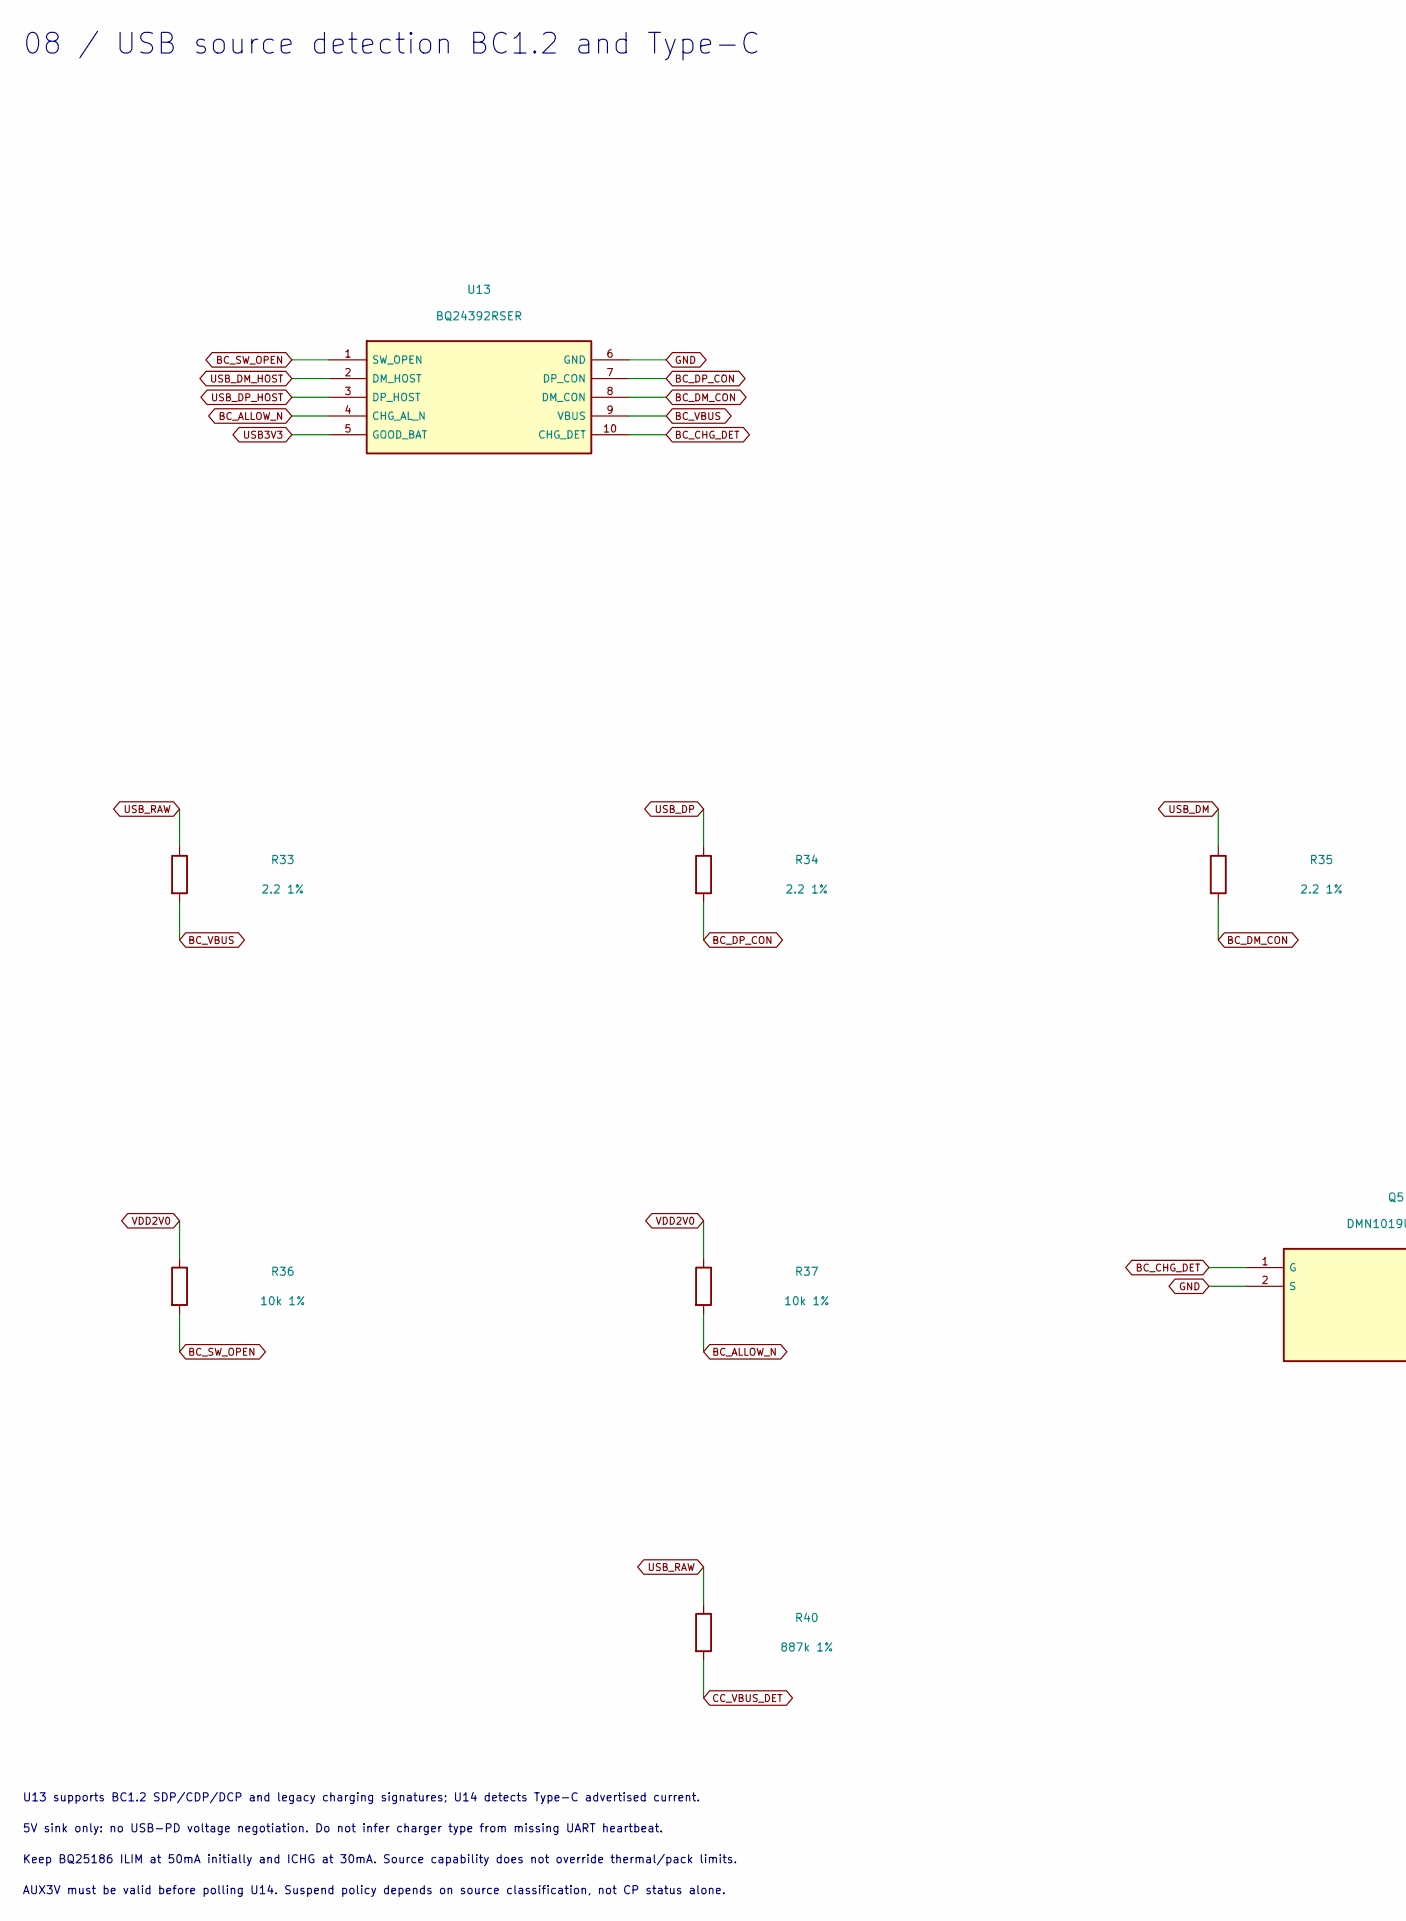
[picture p15: schematic Circuit_08.kicad_sch, USB source detection BC1.2 and Type-C, part in row 1, column 1]

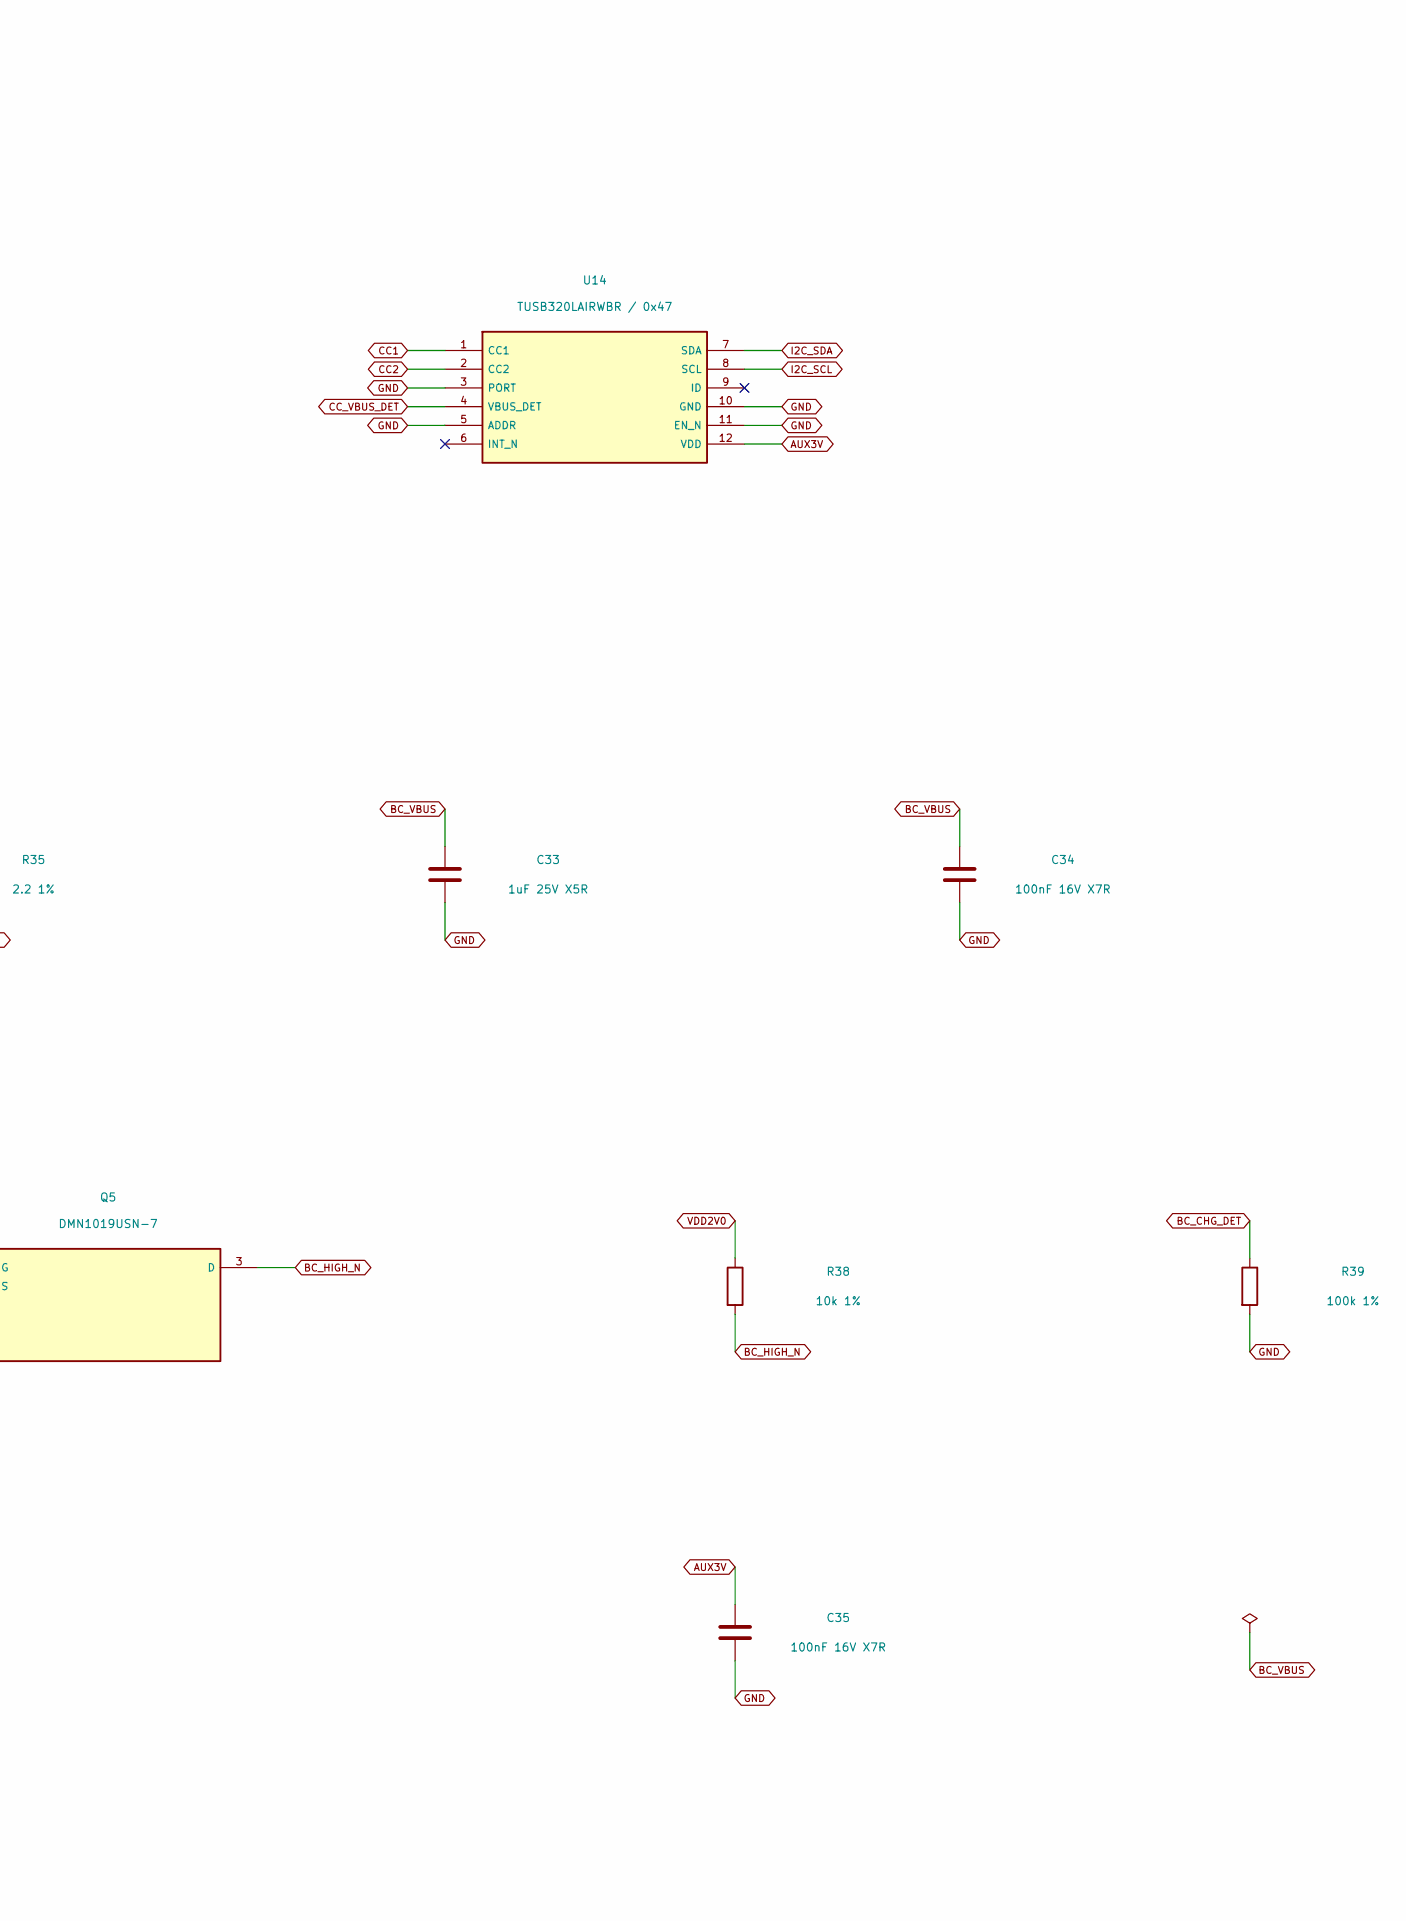
[picture p16: schematic Circuit_08.kicad_sch, USB source detection BC1.2 and Type-C, part in row 1, column 2]

Parts:
C33: 1uF 25V X5R; C_0603_1608Metric; MPN C1608X5R1E105K080AC
C34, C35: 100nF 16V X7R; C_0402_1005Metric; MPN C1005X7R1C104K050BC
Q5: DMN1019USN-7; SC-59; MPN DMN1019USN-7
R33, R34, R35: 2.2 1%; R_0402_1005Metric; MPN RC0402FR-072R2L
R36, R37, R38: 10k 1%; R_0402_1005Metric; MPN RC0402FR-0710KL
R39: 100k 1%; R_0402_1005Metric; MPN RC0402FR-07100KL
R40: 887k 1%; R_0402_1005Metric; MPN RC0402FR-07887KL
U13: BQ24392RSER; Texas_UQFN-10_1.5x2mm_P0.5mm; MPN BQ24392RSER
U14: TUSB320LAIRWBR / 0x47; Texas_X2QFN-12_1.6x1.6mm_P0.4mm; MPN TUSB320LAIRWBR

Connections:
AUX3V: C35.1, U14.12 (VDD); also elsewhere on the board
BC_ALLOW_N: R37.2, U13.4 (CHG_AL_N); also elsewhere on the board
BC_CHG_DET: Q5.1 (G), R39.1, U13.10 (CHG_DET)
BC_DM_CON: R35.2, U13.8 (DM_CON)
BC_DP_CON: R34.2, U13.7 (DP_CON)
BC_HIGH_N: Q5.3 (D), R38.2; also elsewhere on the board
BC_SW_OPEN: R36.2, U13.1 (SW_OPEN); also elsewhere on the board
BC_VBUS: C33.1, C34.1, R33.2, U13.9 (VBUS)
CC1: U14.1 (CC1); also elsewhere on the board
CC2: U14.2 (CC2); also elsewhere on the board
CC_VBUS_DET: R40.2, U14.4 (VBUS_DET)
GND: C33.2, C34.2, C35.2, Q5.2 (S), R39.2, U13.6 (GND), U14.3 (PORT), U14.5 (ADDR), U14.10 (GND), U14.11 (EN_N); also elsewhere on the board
I2C_SCL: U14.8 (SCL); also elsewhere on the board
I2C_SDA: U14.7 (SDA); also elsewhere on the board
USB3V3: U13.5 (GOOD_BAT); also elsewhere on the board
USB_DM: R35.1; also elsewhere on the board
USB_DM_HOST: U13.2 (DM_HOST); also elsewhere on the board
USB_DP: R34.1; also elsewhere on the board
USB_DP_HOST: U13.3 (DP_HOST); also elsewhere on the board
USB_RAW: R33.1, R40.1; also elsewhere on the board
VDD2V0: R36.1, R37.1, R38.1; also elsewhere on the board

Notes on the sheet:
08 / USB source detection BC1.2 and Type-C
U13 supports BC1.2 SDP/CDP/DCP and legacy charging signatures; U14 detects Type-C advertised current.
5V sink only: no USB-PD voltage negotiation. Do not infer charger type from missing UART heartbeat.
Keep BQ25186 ILIM at 50mA initially and ICHG at 30mA. Source capability does not override thermal/pack limits.
AUX3V must be valid before polling U14. Suspend policy depends on source classification, not CP status alone.

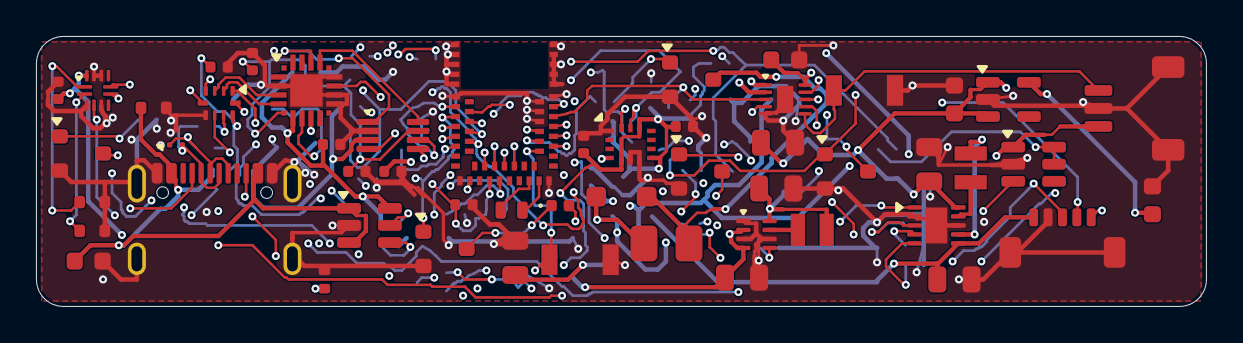
[picture p17: board SentiFrame.kicad_pcb from above]

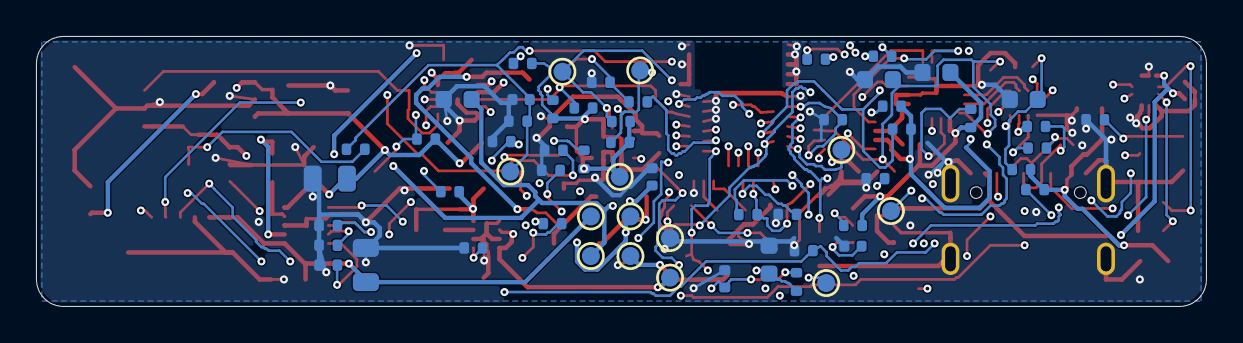
[picture p18: board SentiFrame.kicad_pcb from below]

Board: 4 copper layers, 65.0 x 15.0 mm, 113 parts (61 on the bottom side), 66 nets.

Other parts of the board:
C5, C6: 100nF 16V X7R; C_0402_1005Metric
J4: SM05B-SURS-TF / PPG MAIN; JST_SUR_SM05B-SURS-TF_J4_SilkClearance
R13: 10k 1%; R_0402_1005Metric
R14: 100k 1%; R_0402_1005Metric
U2: BMI270 / I2C 0x68; BMI270_LGA14_DS00008

Their connections:
GND: C5.2, C6.2, J4.2, J4.MP, R14.2, U2.1, U2.6, U2.7; also elsewhere on the board
I2C_SCL: J4.4, U2.13; also elsewhere on the board
I2C_SDA: J4.3, U2.14; also elsewhere on the board
IMU_INT: R14.1, U2.4; also elsewhere on the board
PPG5V: J4.1; also elsewhere on the board
PPG_INT_N: J4.5, R13.2; also elsewhere on the board
VDD2V0: C5.1, C6.1, R13.1, U2.5, U2.8, U2.12; also elsewhere on the board
