shjoo0407/SentiFrame/(commit log)

2026-11-08 feat: Initial commit (#5)
    * feat: Initial commit
    - KiCad 메인 보드와 PPG 보드 회로·PCB 설계 추가
    - nRF54L15 기반 IMU·PPG 센서 제어 및 충전 보호 구현
    - USB·BLE 데이터 통신과 라즈베리파이 수신 프로그램 추가
    - 충전·IMU·PPG 기능별 활성화 설정 지원
    - 낙상 감지 알고리즘 평가 코드와 분석 결과 추가
    - 로컬 테스트·빌드 도구 및 펌웨어 배포본 구성
    - 제조·검증 문서, 부품 목록 및 발표자료 정리
    - 프로젝트와 펌웨어 Git 제외 규칙 추가
    * HW: 참고 자료 원본을 저장소에서 빼고 링크로 대체 (리뷰 반영)
    - assets/datasheets, assets/upstream, pcba-passives 의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
    [C1005X5R1E105K050BC-bias.csv, C1608X5R1E105K080AC-bias.csv, C1608X5R1E475K080AC-bias.csv, C2012X5R1E106K125AB-bias.csv, C2012X5R1E226M125AC-bias.csv, Catalog_01.kicad_sch, Catalog_02.kicad_sch, Catalog_03.kicad_sch]
2026-11-09 [SW] - 파일 구조 정리와 실시간 평가로 전환 (#6)
    * SW: 이전 실험 스크립트를 archive 로 이동
    같은 실험의 여러 버전(stat_test, stat_test3, ml_dl_test, ml_dl-test1, Lo, Li, au)을 SW/archive 로 옮기고,
    결과를 믿으면 안 되는 이유(라벨·센서·열 선택·분할·임계값·시간 측정 문제)를 README 에 남긴다.
    * SW: 누락된 models.py 추가
    compare_models.py 가 불러오는 models.py(fit_detectors, 여섯 모델 정의)가 저장소에 없어 실행이 되지 않았다.
    멘티가 작성한 원본을 그대로 추가한다.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
2026-11-09 [HW] - .gitignore 정리와 문서 추가 (#7)
    * HW: .gitignore 정리, HW·펌웨어 README와 통신 프로토콜 문서 추가
    - .gitignore: 주석의 의도와 반대로 boards/, tools/, docs/, *.md 를 빼던 줄을 지운다.
    이 저장소에 없는 경로(/ml, /presentations)도 정리한다. 빌드 결과물과 release/ 배포 파일은 계속 뺀다
    - HW/README.md: 보드 구성, 회로도 시트, KiCad 로 여는 법, 아직 저장소에 없는 파일
    - firmware/README.md: 폴더, 기능 설정, 컴퓨터에서 돌리는 테스트(확인한 명령), 낙상 판정 알고리즘
    - firmware/PROTOCOL.md: USB·BLE 연결, 프레임, 패킷별 페이로드 — 수신 프로그램 작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
